TheZyklopp/Tretboot/README.md

# 🚤 Tretboot – Konstruktionsprojekt

## 📌 Projektbeschreibung

Dieses Projekt entstand im Rahmen einer universitären Aufgabe im Modul **Konstruktion**. Ziel war die Entwicklung und Konstruktion eines funktionsfähigen **Tretboots** mithilfe moderner CAD-Software.

---

## 🎯 Zielsetzung

* Entwicklung eines vollständigen 3D-CAD-Modells eines Tretboots
* Konstruktion aller relevanten Baugruppen
* Berücksichtigung von:

  * Funktionalität
  * Stabilität
  * Fertigbarkeit
  * Montage

---

## 🛠️ Inhalte des Projekts

Das Repository enthält:

* 📐 **CAD-Modelle** (Einzelteile & Baugruppen)
* 🧩 **Zusammenbau (Assembly)** des Tretboots
* 📄 **Technische Zeichnungen**
* ⚙️ Konstruktive Lösungen für:

  * Antriebssystem (Pedale → Vortrieb)
  * Rumpf / Schwimmkörper
  * Lenkmechanismus

---

## ⚙️ Funktionsprinzip

Das Tretboot basiert auf einem klassischen mechanischen Antrieb:

1. Fahrer tritt Pedale
2. Kraftübertragung über Kurbel und Antriebssystem
3. Umsetzung der Energie in Vortrieb (z. B. Propeller oder Schaufelrad)
4. Steuerung über Rudermechanismus

👉 Die Antriebskraft wird direkt durch Muskelkraft erzeugt und mechanisch weitergeleitet ([Google Patente][2])

---

## 🧠 Konstruktive Schwerpunkte

* 💡 **Leichtbauweise** zur Effizienzsteigerung
* ⚖️ **Stabilität im Wasser** (z. B. Katamaran-Prinzip)
* 🔧 **Modularer Aufbau** für einfache Montage
* 🔄 **Kraftübertragung** mit möglichst geringem Verlust

---

## 🧪 Vorgehensweise

1. Konzeptentwicklung
2. Skizzierung und Ideengenerierung
3. 3D-Modellierung (CAD)
4. Baugruppenbildung
5. Optimierung der Konstruktion
6. Erstellung technischer Zeichnungen

---

## 👨‍🎓 Kontext

* Studiengang: **Ingenieursinformatik**
* Modul: **Konstruktion
* Projektart: **Gruppenprojekt**

---

## 📦 Nutzung

Dieses Repository dient:

* zur Dokumentation des Projekts
* zur Präsentation der Konstruktion
* als Referenz für ähnliche CAD-Projekte

---

## ⚠️ Hinweise

* Das Projekt ist ein **Studienprojekt** und nicht für die Serienproduktion ausgelegt
* CAD-Dateien können je nach Softwareversion variieren

---

## 👥 Autoren

* Gruppe 7 – Konstruktion
* Philip
* Julian
* Yazan
* Ahmed

---

## 📄 Lizenz

Dieses Projekt dient ausschließlich zu Lehr- und Demonstrationszwecken.
