TheZyklopp/Tretboot/Konzept/Teil2/Zulässiges_Gesamtgewicht_Gruppe7.pdf

## 1 Geometrie des Schwimmkörpers

Der Schwimmkörper besteht aus zwei identischen Schwimmwülsten. Jeder Wulst setzt sich aus einem zylindrischen Teil und einer kugelförmigen Endform zusammen.

### 1.1 Gegebene Größen

- Außendurchmesser: Daußen = 0,20 m
- Wanddicke: t = 0,002 m
- Zylinderlänge (innen): LZyl = 2,8 m
- Anzahl der Schwimmwülste: n = 2

### 1.2 Innenabmessungen

Der Innendurchmesser ergibt sich zu:

Dinnen = Daußen − 2t = 0,20 − 2 · 0,002 = 0,196 m

Der Innenradius beträgt somit:

r =

Dinnen
2

= 0,098 m

## 2 Berechnung des Innenvolumens

### 2.1 Volumen des Zylinders

VZyl = πr²LZyl

VZyl = π · (0,098)²
- 2,8 ≈ 0,0846 m

3

### 2.2 Volumen der Kugel

VKugel =

4
3

πr³

VKugel =

4
3

π · (0,098)³ ≈ 0,00394 m

3

### 2.3 Gesamtvolumen eines Schwimmwulstes

V1 = VZyl + VKugel

V1 ≈ 0,0885 m

3

### 2.4 Gesamtvolumen beider Schwimmwülste

Vgesamt = 2 · V1 = 2 · 0,0885 = 0,177 m

3

## 3 Auftriebskraft

Die Auftriebskraft wird nach dem archimedischen Prinzip berechnet:

FA = ρ · g · V

mit:

- Wasserdichte: ρ = 1000 kg/m³
- Erdbeschleunigung: g = 9,81 m/s²

FA = 1000 · 9,81 · 0,177 ≈ 1736 N

## 4 Gewichtskraft des Boots

Die Masse des Boots beträgt:
mBoot = 46 kg

Die Gewichtskraft ergibt sich zu:

FG = mBoot · g = 46 · 9,81 ≈ 451 N

## 5 Nutzlast

Die maximal tragbare Masse ergibt sich aus:

mmax =

FA
g

=

1736
9,81

≈ 177 kg

Abzüglich der Bootsmasse ergibt sich die theoretische Nutzlast:

mNutz = 177 − 46 ≈ 131 kg

## 6 Ergebnis

Die beiden Schwimmwülste erzeugen eine maximale Auftriebskraft von ca. 1,74 kN. Nach Abzug des Eigengewichts des Boots verbleibt eine theoretische Nutzlast von etwa 131 kg. In der Praxis ist aufgrund von Sicherheitsfaktoren eine geringere Nutzlast anzusetzen.

## 7 Sicherheitsfaktor

Der Sicherheitsfaktor gegen Sinken wird als Verhältnis der maximalen Auftriebskraft zur Gewichtskraft des Boots definiert:

S =

FA
FG

Mit:
FA = 1736 N und FG = 451 N

ergibt sich:

S =

1736
451

≈ 3,85

Der Sicherheitsfaktor beträgt somit:

S ≈ 3,9

Dies bedeutet, dass der Schwimmkörper das rund 3,9-fache seines Eigengewichts tragen kann, bevor ein vollständiges Eintauchen erfolgt.
