TheZyklopp/Tretboot/Konzept/Teil2/Preisliste_Gruppe7.pdf

## Preisliste

Bauteilnummer Bezeichnung | Anzahl | Einzelpreis in € | Gesamtpreis in €
1 | Anschlag | 4
2 | Sitzlehne (Rohteil) | 1 | 28,47 | 28,47
3 | Sitzplatte (Rohteil) 1 | 28,47 | 28,47
4 | Stopper | 4
5 | Tritt OT | 2
6 | Tritt UT | 2
7 | Trittstange | 1
8 | Stopper klein | 4
9 | Verbinder | 2
10 | Distanz | 1
11 | Schaufelplatten | 4
12 | Seitenscheibe | 2
13 | Schwimmkörper | 2
14 | Ringschrauben-
| mutter | 4 | 4,9 | 19,6
15 | Lager Schaufelrad 2 | 11,18 | 22,36
16 | Quertraverse vorne
| (Rohteil) | 2 | 13,45 | 26,9
17 | Traversen Deckel 10
18 | Quertraverse Sitz
| (Rohteil) | 2 | 13,45 | 26,9
19 | Längs Traverse
| vorne (Rohteil) | 2 | 13,45 | 26,9
20 | Längs Traverse
| hinten (Rohteil) | 2 | 13,45 | 26,9
21 | Stange Schaufelrad 2
22 | Scharnier 1488A1 | 2 | 30,03 | 60,06
23 | Steuerteil | 1
24 | Lager Schaufelrad | 6 | 11,18 | 67,08
25 | Verbinder 3 | 1
26 | Quertraverse Sitz
| (Rohteil) | 1 | 13,45 | 13,45
27 | Ruder | 1
28 | Ruderstange | 1
29 | Verbinder 2 | 1
30 | U Stück | 4
31 | Verbindung | 1
32 | Steuerhebel | 1
33 | Kettenrad V
| 6799K144 | 1 | 114,91 | 144,91
34 | Kettenrad H
| 6799K141 | 1 | 95,88 | 95,88
35 | Rollkette 7210K2
| 15ft. | 1 | 120,47 | 120,47
36 | 18-8 Clevis Pin
| 90378A705 | 4 | 7,4 | 29,6

37 | Schrader- Ventil | 2
38 | Cotter Pin
| 98350A111 | 4 | 1,54 | 6,16
39 | Sechskantmutter
| M10 | 16 | 0,35 | 5,6
40 | Innensechskant-
| schraube M5x8 | 2 | 0,1 | 0,2
41 | Innensechskant-
| schraube M5x25 | 1 | 0,06 | 0,06
42 | Innensechskant-
| schraube M8x25 | 2 | 0,11 | 0,22
43 | Innensechskant-
| schraube M8x16 | 2 | 0,1 | 0,2
44 | Innensechskant-
| Schraube M5x16 | 2 | 0,33 | 0,66
45 | Innensechskant-
| schraube M10x60 | 14 | 0,59 | 8,24
46 | Innensechskant-
| schraubeM5x20 | 16 | 0,33 | 5,28
47 | Unterlegscheibe | 2 | 0,1 | 0,2
48 | Innensechskant-
| schraube mit
| Senkkopf M10x70 | 4 | 1,33 | 5,32
49 | Innensechskant-
| schraube mit
| Senkkopf M6x60 | 4 | 0,74 | 2,96
50 | Innensechskant-
| schraube mit
| Senkkopf M8x40 | 8 | 0,41 | 3,28
51 | Innensechskant-
| schraube mit
| Senkkopf M5x50 | 8 | 0,51 | 4,08
52 | Rod Nut 8404N13 | 3 | 20,06 | 60,18
| | | | 840,61

### Die Preise der restlichen Teile werden ggf. nachgereicht nach anfrage der

Fertigungskosten bei einer Firma.
