TheZyklopp/Tretboot/Konzept/Teil1/Papierkorb/Funktionsstruktur  (1).pdf

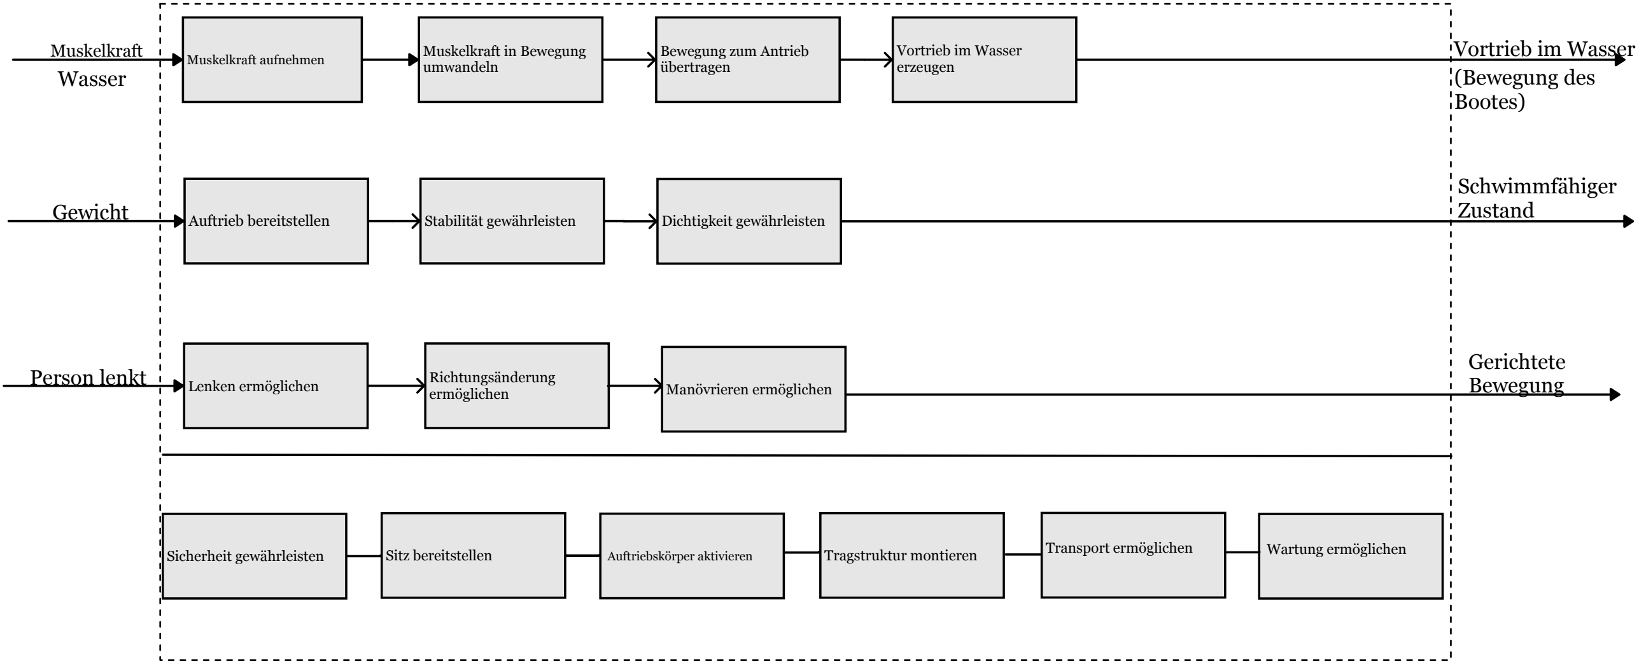
[picture p1: figure]
Muskelkraft aufnehmen; Muskelkraft in Bewegung; umwandeln; Bewegung zum Antrieb übertragen; Vortrieb im Wasser erzeugen; Auftrieb bereitstellen; Stabilität gewährleisten; Dichtigkeit gewährleisten; Lenken ermöglichen; (Bewegung des Bootes); Schwimmfähiger Zustand; Gerichtete Bewegung; Muskelkraft; Vortrieb im Wasser; Wasser; Gewicht; Person lenkt; Sicherheit gewährleisten; Sitz bereitstellen; Auftriebskörper aktivieren; Richtungsänderung; ermöglichen; Manövrieren ermöglichen; Tragstruktur montieren; Transport ermöglichen; Wartung ermöglichen
