TheZyklopp/Tretboot/Konzept/Teil2/Stückliste_Gruppe7.pdf

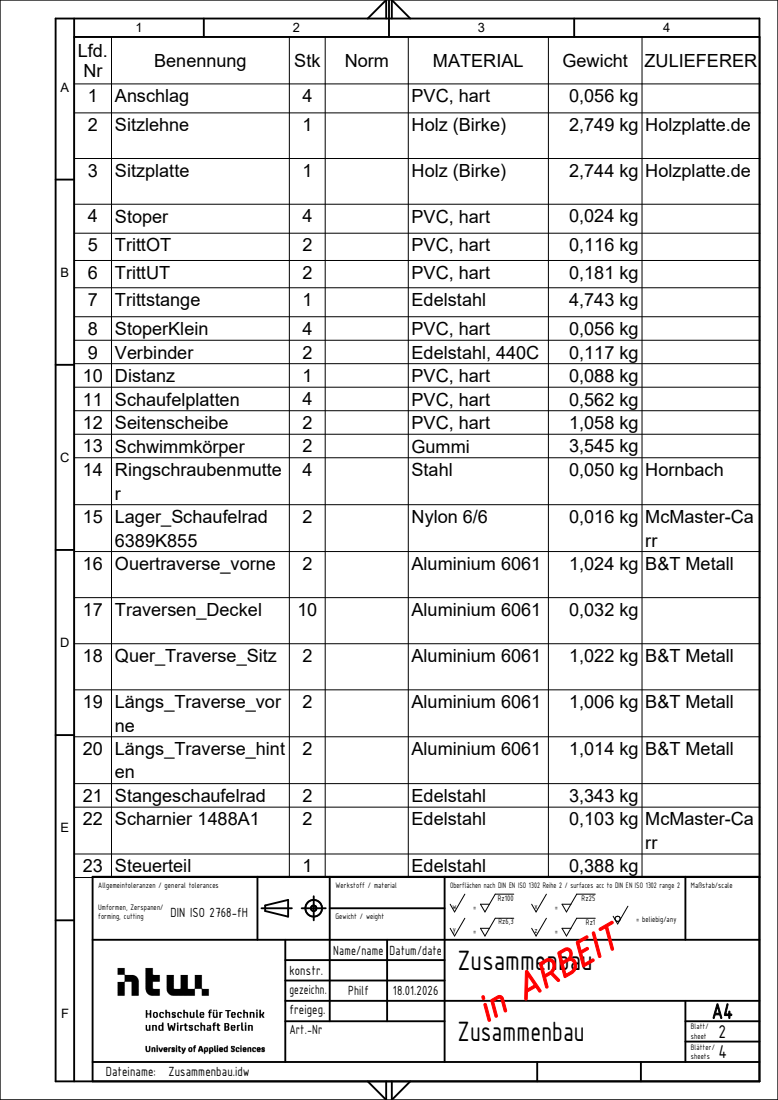
[picture p4: page 1]
sheets; in ARBEIT

Nr | Benennung | Stk | Norm | MATERIAL | Gewicht | ZULIEFERER Lfd.

1 | Anschlag | 4 | | PVC, hart | 0,056 kg
2 | Sitzlehne | 1 | | Holz (Birke) | 2,749 kg | Holzplatte.de

3 | Sitzplatte | 1 | | Holz (Birke) | 2,744 kg | Holzplatte.de

4 | Stoper | 4 | | PVC, hart | 0,024 kg
5 | TrittOT | 2 | | PVC, hart | 0,116 kg
6 | TrittUT | 2 | | PVC, hart | 0,181 kg
7 | Trittstange | 1 | | Edelstahl | 4,743 kg
8 | StoperKlein | 4 | | PVC, hart | 0,056 kg
9 | Verbinder | 2 | | Edelstahl, 440C | 0,117 kg
C | 10 | Distanz | 1 | | PVC, hart | 0,088 kg
11 | Schaufelplatten | 4 | | PVC, hart | 0,562 kg
12 | Seitenscheibe | 2 | | PVC, hart | 1,058 kg
13 | Schwimmkörper | 2 | | Gummi | 3,545 kg
14 | Ringschraubenmutte r | 4 | | Stahl | 0,050 kg | Hornbach

15 | Lager_Schaufelrad 6389K855 | 2 | | Nylon 6/6 | 0,016 kg | McMaster-Ca rr

D | 16 | Ouertraverse_vorne | 2 | | Aluminium 6061 | 1,024 kg | B&T Metall

17 | Traversen_Deckel | 10 | | Aluminium 6061 | 0,032 kg

18 | Quer_Traverse_Sitz | 2 | | Aluminium 6061 | 1,022 kg | B&T Metall

19 | Längs_Traverse_vor ne | 2 | | Aluminium 6061 | 1,006 kg | B&T Metall

E | 20 | Längs_Traverse_hint en | 2 | | Aluminium 6061 | 1,014 kg | B&T Metall

21 | Stangeschaufelrad | 2 | | Edelstahl | 3,343 kg
22 | Scharnier 1488A1 | 2 | | Edelstahl | 0,103 kg | McMaster-Ca rr

23 | Steuerteil | 1 | | Edelstahl | 0,388 kg

Allgemeintoleranzen / general tolerances forming, cutting DIN ISO 2768-fH | | | | | | Oberflächen nach DIN EN ISO 1302 Reihe 2 / surfaces acc to DIN EN ISO 1302 range 2 y = = Rz1 z = Rz100 x = Rz25 Rz6,3 = beliebig/any w | Maßstab/scale Umformen, Zerspanen/

Zusammenbau Werkstoff / material Gewicht / weight

Name/name | Datum/date
konstr.
gezeichn. | Philf | 18.01.2026
freigeg. | | | Zusammenbau | A4
Art.-Nr | | | | 2 Blatt/ sheet Blätter/

Dateiname: Zusammenbau.idw

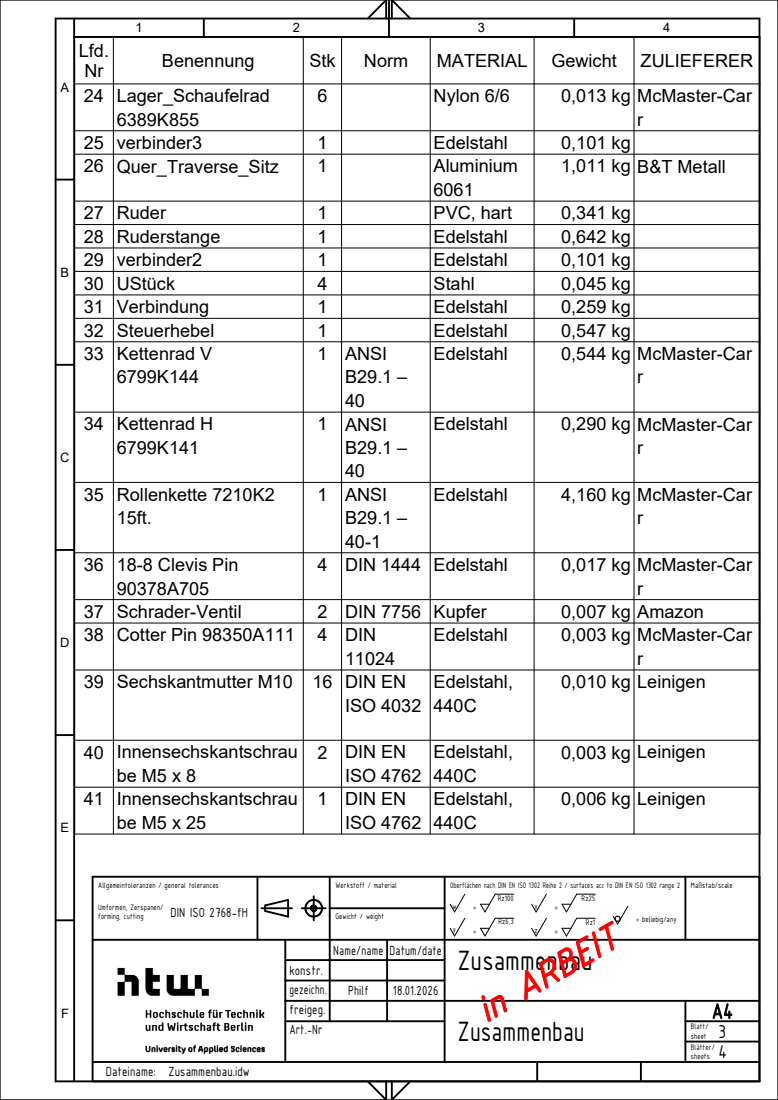
[picture p5: page 2]
3 Blatt/; in ARBEIT

24 | Lager_Schaufelrad 6389K855 | 6 | | Nylon 6/6 | 0,013 kg | McMaster-Car r

25 | verbinder3 | 1 | | Edelstahl | 0,101 kg
26 | Quer_Traverse_Sitz | 1 | | Aluminium 6061 | 1,011 kg | B&T Metall

27 | Ruder | 1 | | PVC, hart | 0,341 kg
28 | Ruderstange | 1 | | Edelstahl | 0,642 kg
29 | verbinder2 | 1 | | Edelstahl | 0,101 kg
30 | UStück | 4 | | Stahl | 0,045 kg
31 | Verbindung | 1 | | Edelstahl | 0,259 kg
32 | Steuerhebel | 1 | | Edelstahl | 0,547 kg
33 | Kettenrad V 6799K144 | 1 | ANSI B29.1 – 40 | Edelstahl | 0,544 kg | McMaster-Car r

34 | Kettenrad H 6799K141 | 1 | ANSI B29.1 – 40 | Edelstahl | 0,290 kg | McMaster-Car r

35 | Rollenkette 7210K2 15ft. | 1 | ANSI B29.1 – 40-1 | Edelstahl | 4,160 kg | McMaster-Car r

D | 36 | 18-8 Clevis Pin 90378A705 | 4 | DIN 1444 | Edelstahl | 0,017 kg | McMaster-Car r

37 | Schrader-Ventil | 2 | DIN 7756 | Kupfer | 0,007 kg | Amazon
38 | Cotter Pin 98350A111 | 4 | DIN 11024 | Edelstahl | 0,003 kg | McMaster-Car r

39 | Sechskantmutter M10 | 16 | DIN EN ISO 4032 | Edelstahl, 440C | 0,010 kg | Leinigen

40 | Innensechskantschrau be M5 x 8 | 2 | DIN EN ISO 4762 | Edelstahl, 440C | 0,003 kg | Leinigen

41 | Innensechskantschrau be M5 x 25 | 1 | DIN EN ISO 4762 | Edelstahl, 440C | 0,006 kg | Leinigen

Allgemeintoleranzen / general tolerances forming, cutting DIN ISO 2768-fH | | | | | Oberflächen nach DIN EN ISO 1302 Reihe 2 / surfaces acc to DIN EN ISO 1302 range 2 y = = Rz1 z = Rz100 x = Rz25 Rz6,3 = beliebig/any w | Maßstab/scale Umformen, Zerspanen/

Zusammenbau Werkstoff / material Gewicht / weight

Name/name | Datum/date
konstr.
gezeichn. | Philf | 18.01.2026
freigeg. | | | | A4

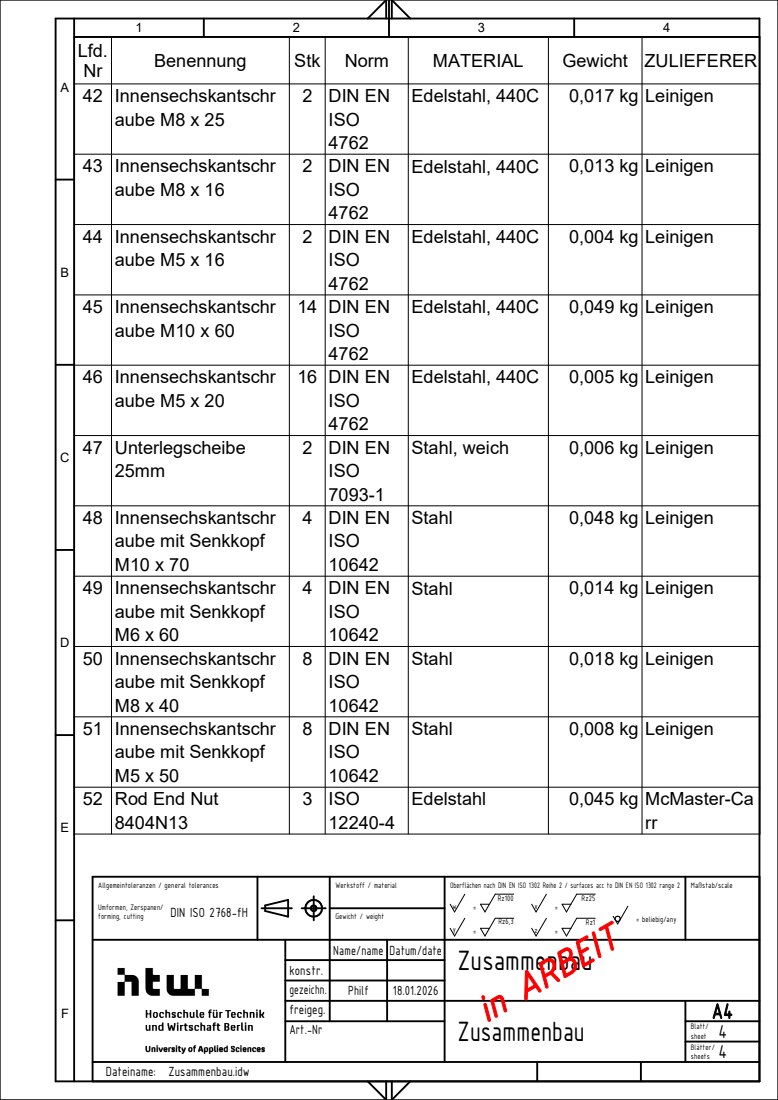
[picture p6: page 3]
4 Blatt/; in ARBEIT

42 | Innensechskantschr aube M8 x 25 | 2 | DIN EN ISO 4762 | Edelstahl, 440C | 0,017 kg | Leinigen

43 | Innensechskantschr aube M8 x 16 | 2 | DIN EN ISO 4762 | Edelstahl, 440C | 0,013 kg | Leinigen

44 | Innensechskantschr aube M5 x 16 | 2 | DIN EN ISO 4762 | Edelstahl, 440C | 0,004 kg | Leinigen

45 | Innensechskantschr aube M10 x 60 | 14 | DIN EN ISO 4762 | Edelstahl, 440C | 0,049 kg | Leinigen

C | 46 | Innensechskantschr aube M5 x 20 | 16 | DIN EN ISO 4762 | Edelstahl, 440C | 0,005 kg | Leinigen

47 | Unterlegscheibe 25mm | 2 | DIN EN ISO 7093-1 | Stahl, weich | 0,006 kg | Leinigen

48 | Innensechskantschr aube mit Senkkopf M10 x 70 | 4 | DIN EN ISO 10642 | Stahl | 0,048 kg | Leinigen

49 | Innensechskantschr aube mit Senkkopf M6 x 60 | 4 | DIN EN ISO 10642 | Stahl | 0,014 kg | Leinigen

50 | Innensechskantschr aube mit Senkkopf M8 x 40 | 8 | DIN EN ISO 10642 | Stahl | 0,018 kg | Leinigen

51 | Innensechskantschr aube mit Senkkopf M5 x 50 | 8 | DIN EN ISO 10642 | Stahl | 0,008 kg | Leinigen

52 | Rod End Nut 8404N13 | 3 | ISO 12240-4 | Edelstahl | 0,045 kg | McMaster-Ca rr

Allgemeintoleranzen / general tolerances forming, cutting DIN ISO 2768-fH | | | | | Oberflächen nach DIN EN ISO 1302 Reihe 2 / surfaces acc to DIN EN ISO 1302 range 2 y = = Rz1 z = Rz100 x = Rz25 Rz6,3 = beliebig/any w | Maßstab/scale Umformen, Zerspanen/

Zusammenbau Werkstoff / material Gewicht / weight

Name/name | Datum/date
konstr.
gezeichn. | Philf | 18.01.2026
freigeg. | | | | A4
