TheZyklopp/Tretboot/(list of files, cad)

Other CAD files:
2D Zeichnungen/Ahmed alamwi/6905N38_Machinable-Bore Corrosion-Resistant Sprocket-2Z.idw
2D Zeichnungen/Ahmed alamwi/Rod End Nuts - KopieZ.idw
2D Zeichnungen/Ahmed alamwi/Valve_end-00Z.idw
2D Zeichnungen/Ahmed alamwi/Valve_seat-Z.idw
2D Zeichnungen/Julian Faber/Längs_Traverse_vorne.idw
2D Zeichnungen/Julian Faber/Quer_Traverse_Sitz.idw
2D Zeichnungen/Julian Faber/Sitzplatte.idw
2D Zeichnungen/Julian Faber/Traversen_Deckel.idw
2D Zeichnungen/Philip Faber/Verbindung.idw
2D Zeichnungen/Philip Faber/ustück.idw
2D Zeichnungen/Yazan Al Hefawi/GestellVerbinder 2D von Yazan Al Hefawi 01.idw
2D Zeichnungen/Yazan Al Hefawi/Schrader_tube_18,5x7.7-1 2D von Alhefawi01.idw
2D Zeichnungen/Yazan Al Hefawi/Verbindung-1 2D Al Hefawi 01.idw
Ahmed/HTW-000166.ipt
Gestell/3112T51_Zinc-Plated Steel Round Eye Nut - for Lifting.ipt
Gestell/Gestell_zsm.iam
Gestell/LagerBund.ipt
Gestell/Lager_Schaufelrad.ipt
Gestell/Längs_Traverse_hinten.ipt
Gestell/Längs_Traverse_vorne.ipt
Gestell/Ouertraverse_vorne.ipt
Gestell/Quer_Traverse_Sitz.ipt
Gestell/Traversen_Deckel.ipt
Gestell/Verbinder.ipt
Gestell/richtungstange.ipt
Konzept/Teil2/Zusammenbau_Gruppe7.iam
Konzept/Teil2/Zusammenbau_Gruppe7.idw
Schwimmkoerper/InnenvolumenLuft.ipt
Schwimmkoerper/Schwimmkoerper.iam
Schwimmkoerper/Ventil_Schrader/Poppet_seal-00.ipt
Schwimmkoerper/Ventil_Schrader/Schrader_bicycle_valve-00.iam
Schwimmkoerper/Ventil_Schrader/Schrader_plug_valve.iam
Schwimmkoerper/Ventil_Schrader/Schrader_tube_18,5x7.7.ipt
Schwimmkoerper/Ventil_Schrader/Vale_outer_seal-00.ipt
Schwimmkoerper/Ventil_Schrader/Valve_cap_seal-00.ipt
Schwimmkoerper/Ventil_Schrader/Valve_end-00.ipt
Schwimmkoerper/Ventil_Schrader/Valve_pin.ipt
Schwimmkoerper/Ventil_Schrader/Valve_seat-.idw
Schwimmkoerper/Ventil_Schrader/Valve_seat-00.ipt
Schwimmkoerper/Ventil_Schrader/Valve_spring-00.ipt
Schwimmkoerper/Ventil_Schrader/Valve_threads-00.ipt
Schwimmkoerper/Wulst.ipt
Sitz/1598A18_Mortise-Mount Hinge with Holes.ipt
Sitz/Gelenk.iam
Sitz/GelenkOT.ipt
Sitz/GelenkStift.ipt
Sitz/GelenkUT.ipt
Sitz/Sitzlehne.ipt
Sitz/Sitzplatte.ipt
Sitz/Stoper.ipt
Sitz/scharnier.iam
Sitz/sitz_zusammenbau.iam
Steuern/6905N38_Machinable-Bore Corrosion-Resistant Sprocket-2.idw
Steuern/ClevisPin.ipt
Steuern/GestellVerbinder 2D von Yazan Al Hefawi.idw
Steuern/HTW-000654.ipt
Steuern/HTW-000679.ipt
Steuern/HTW-000681.ipt
Steuern/HTW-000692.ipt
Steuern/HTW-000702.ipt
Steuern/Rod End Nuts.idw
Steuern/Rod End Nuts.ipt
Steuern/Schrader_tube_18,5x7.7-1 2D von Alhefawi.idw
Steuern/Valve_end-00.idw
Steuern/Verbindung-1 2D Al Hefawi.idw
Steuern/Verbindung.ipt
Steuern/clevisPin30.ipt
Steuern/cotterpin.ipt
Steuern/steuerstange.ipt
Steuern/ustück.ipt
Tritt/6799K141_Machinable-Bore Corrosion-Resistant Sprocket.ipt
Tritt/6799K144_Machinable-Bore Corrosion-Resistant Sprocket/6799K144_Machinable-Bore Corrosion-Resistant Sprocket/6799K144_Machinable-Bore Corr.ipt
Tritt/6905N38_Machinable-Bore Corrosion-Resistant Sprocket.ipt
Tritt/Pedale.iam
Tritt/Stange.iam
Tritt/Stopper.ipt
Tritt/TrittOT.ipt
Tritt/TrittUT.ipt
Tritt/Trittstange.ipt
Tritt/stopper2.ipt
Zusammenbau/Konstruktions-Assistent/HTW-000365.iam
Zusammenbau/Konstruktions-Assistent/HTW-000366.ipt
Zusammenbau/Konstruktions-Assistent/HTW-000642.iam
Zusammenbau/Konstruktions-Assistent/HTW-000643.ipt
schaufelrad/Distanz.ipt
schaufelrad/Schaufelplatten.ipt
schaufelrad/Schaufelrad.iam
schaufelrad/Seitenscheibe.ipt
schaufelrad/Stangeschaufelrad.ipt
