TheZyklopp/Tretboot/Konzept/Teil1/Papierkorb/Skizze Boot.pdf

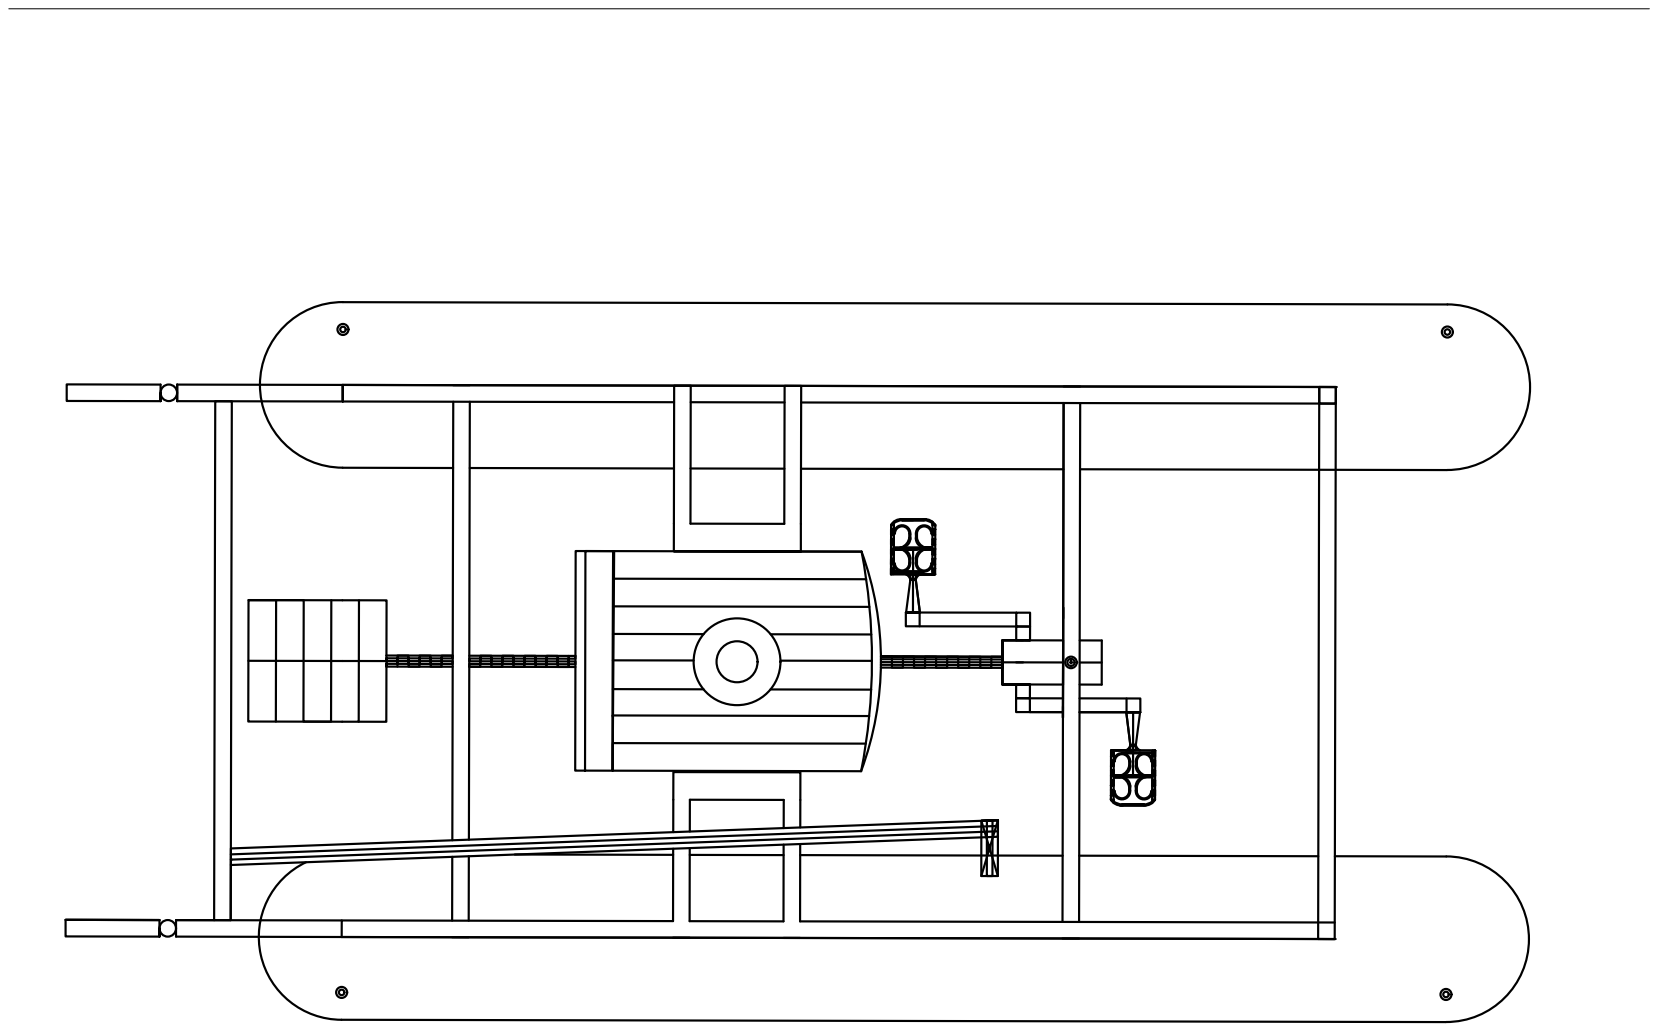
[picture p29: page 1]
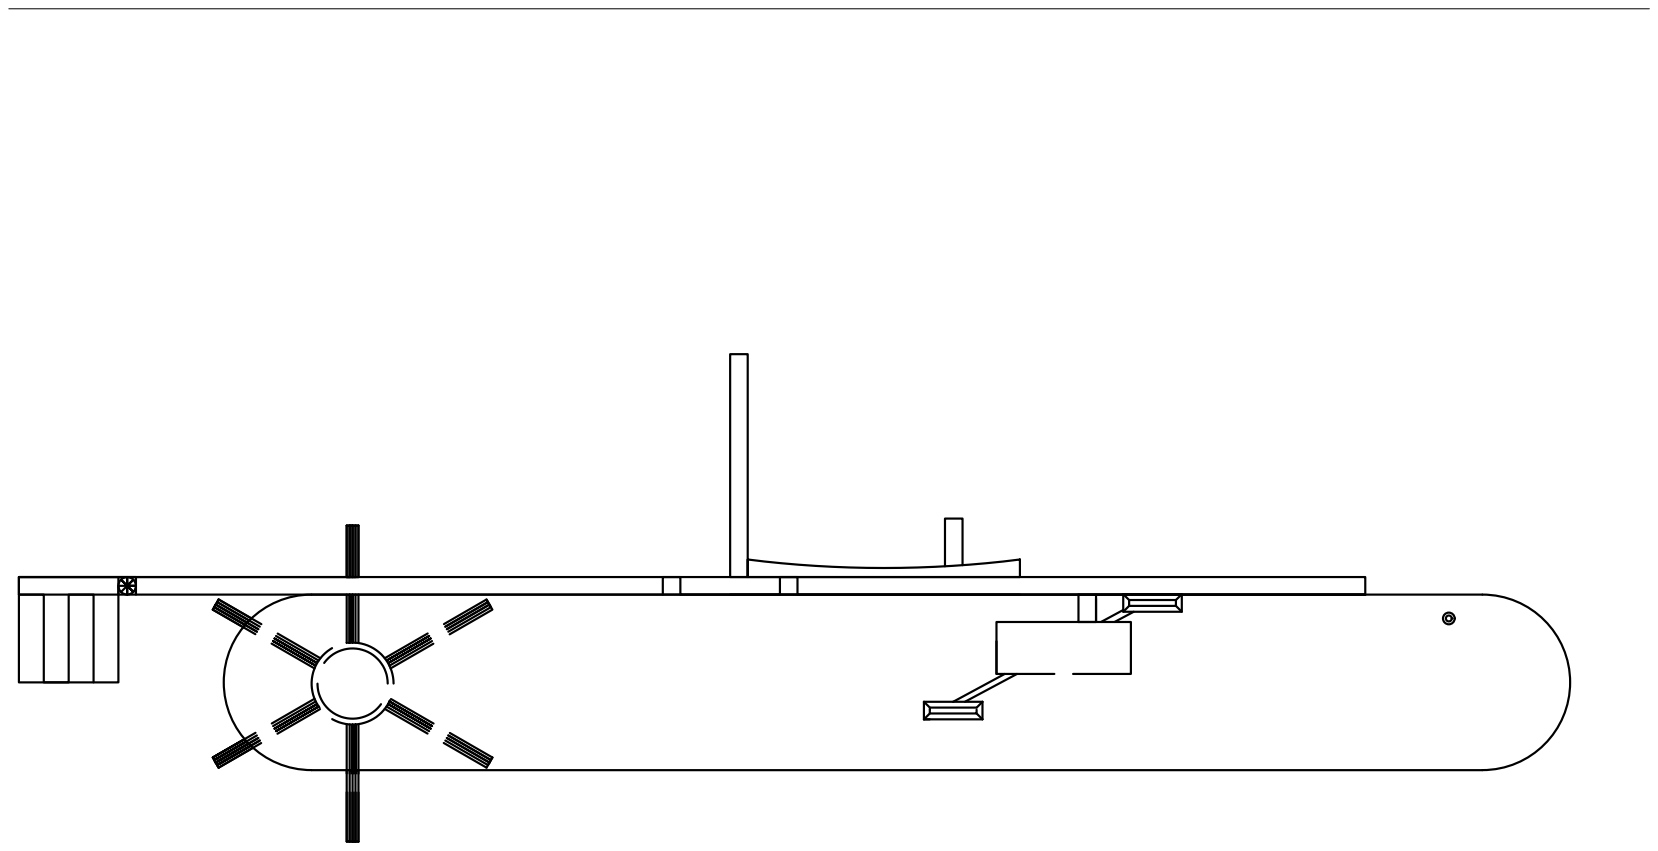
[picture p30: page 2]
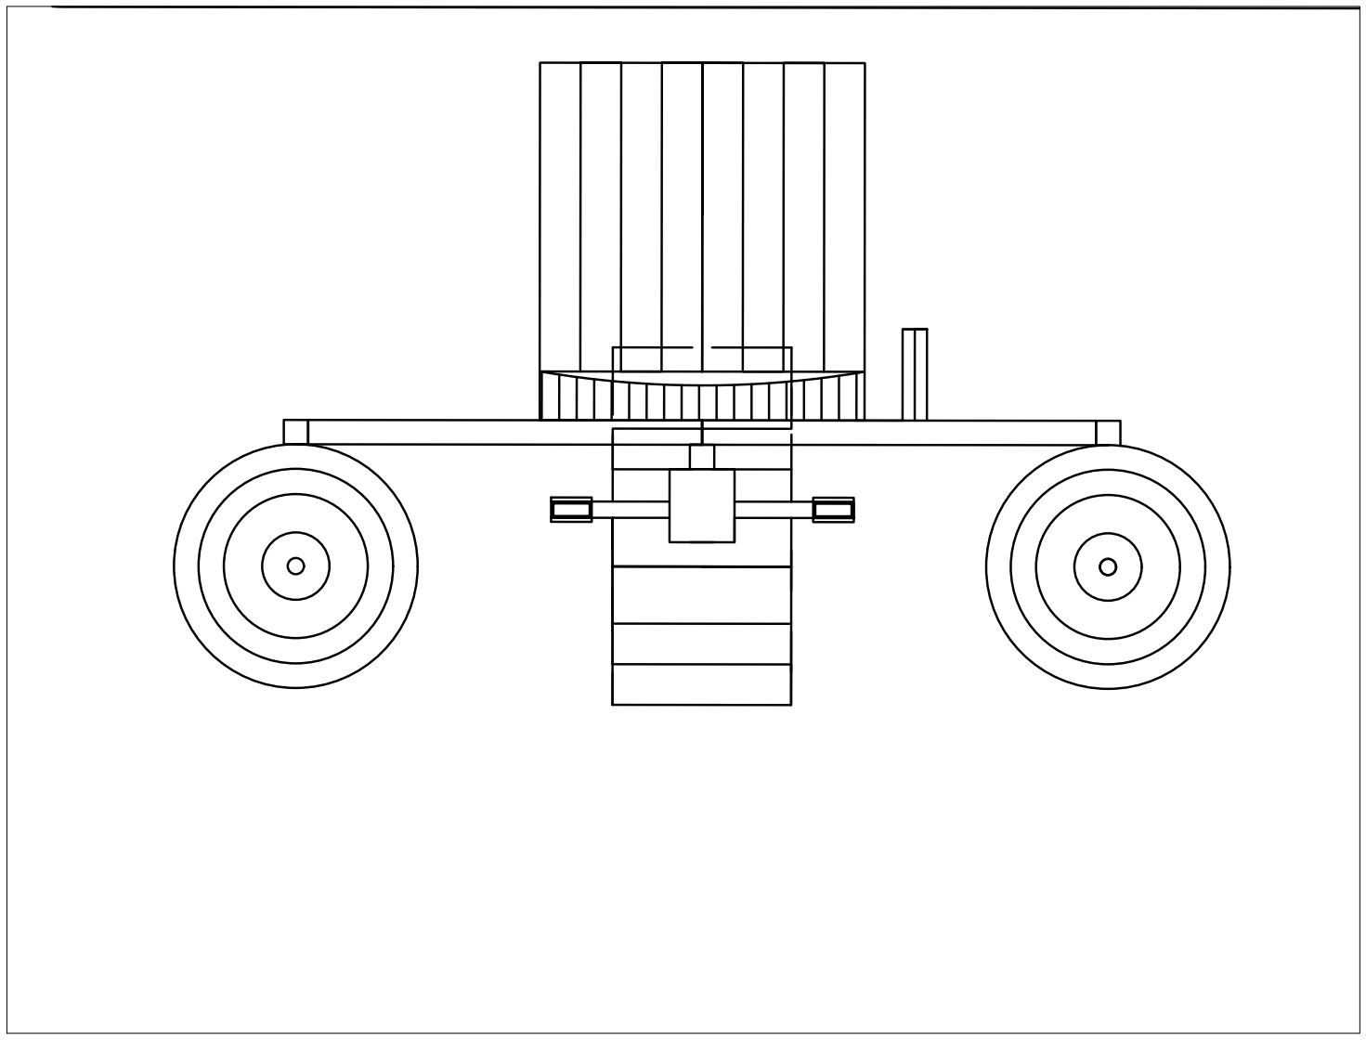
[picture p31: figure]
