TheZyklopp/Tretboot/2D Zeichnungen/Ahmed alamwi/6905N38_Machinable-Bore Corrosion-Resistant Sprocket-2Z1.pdf

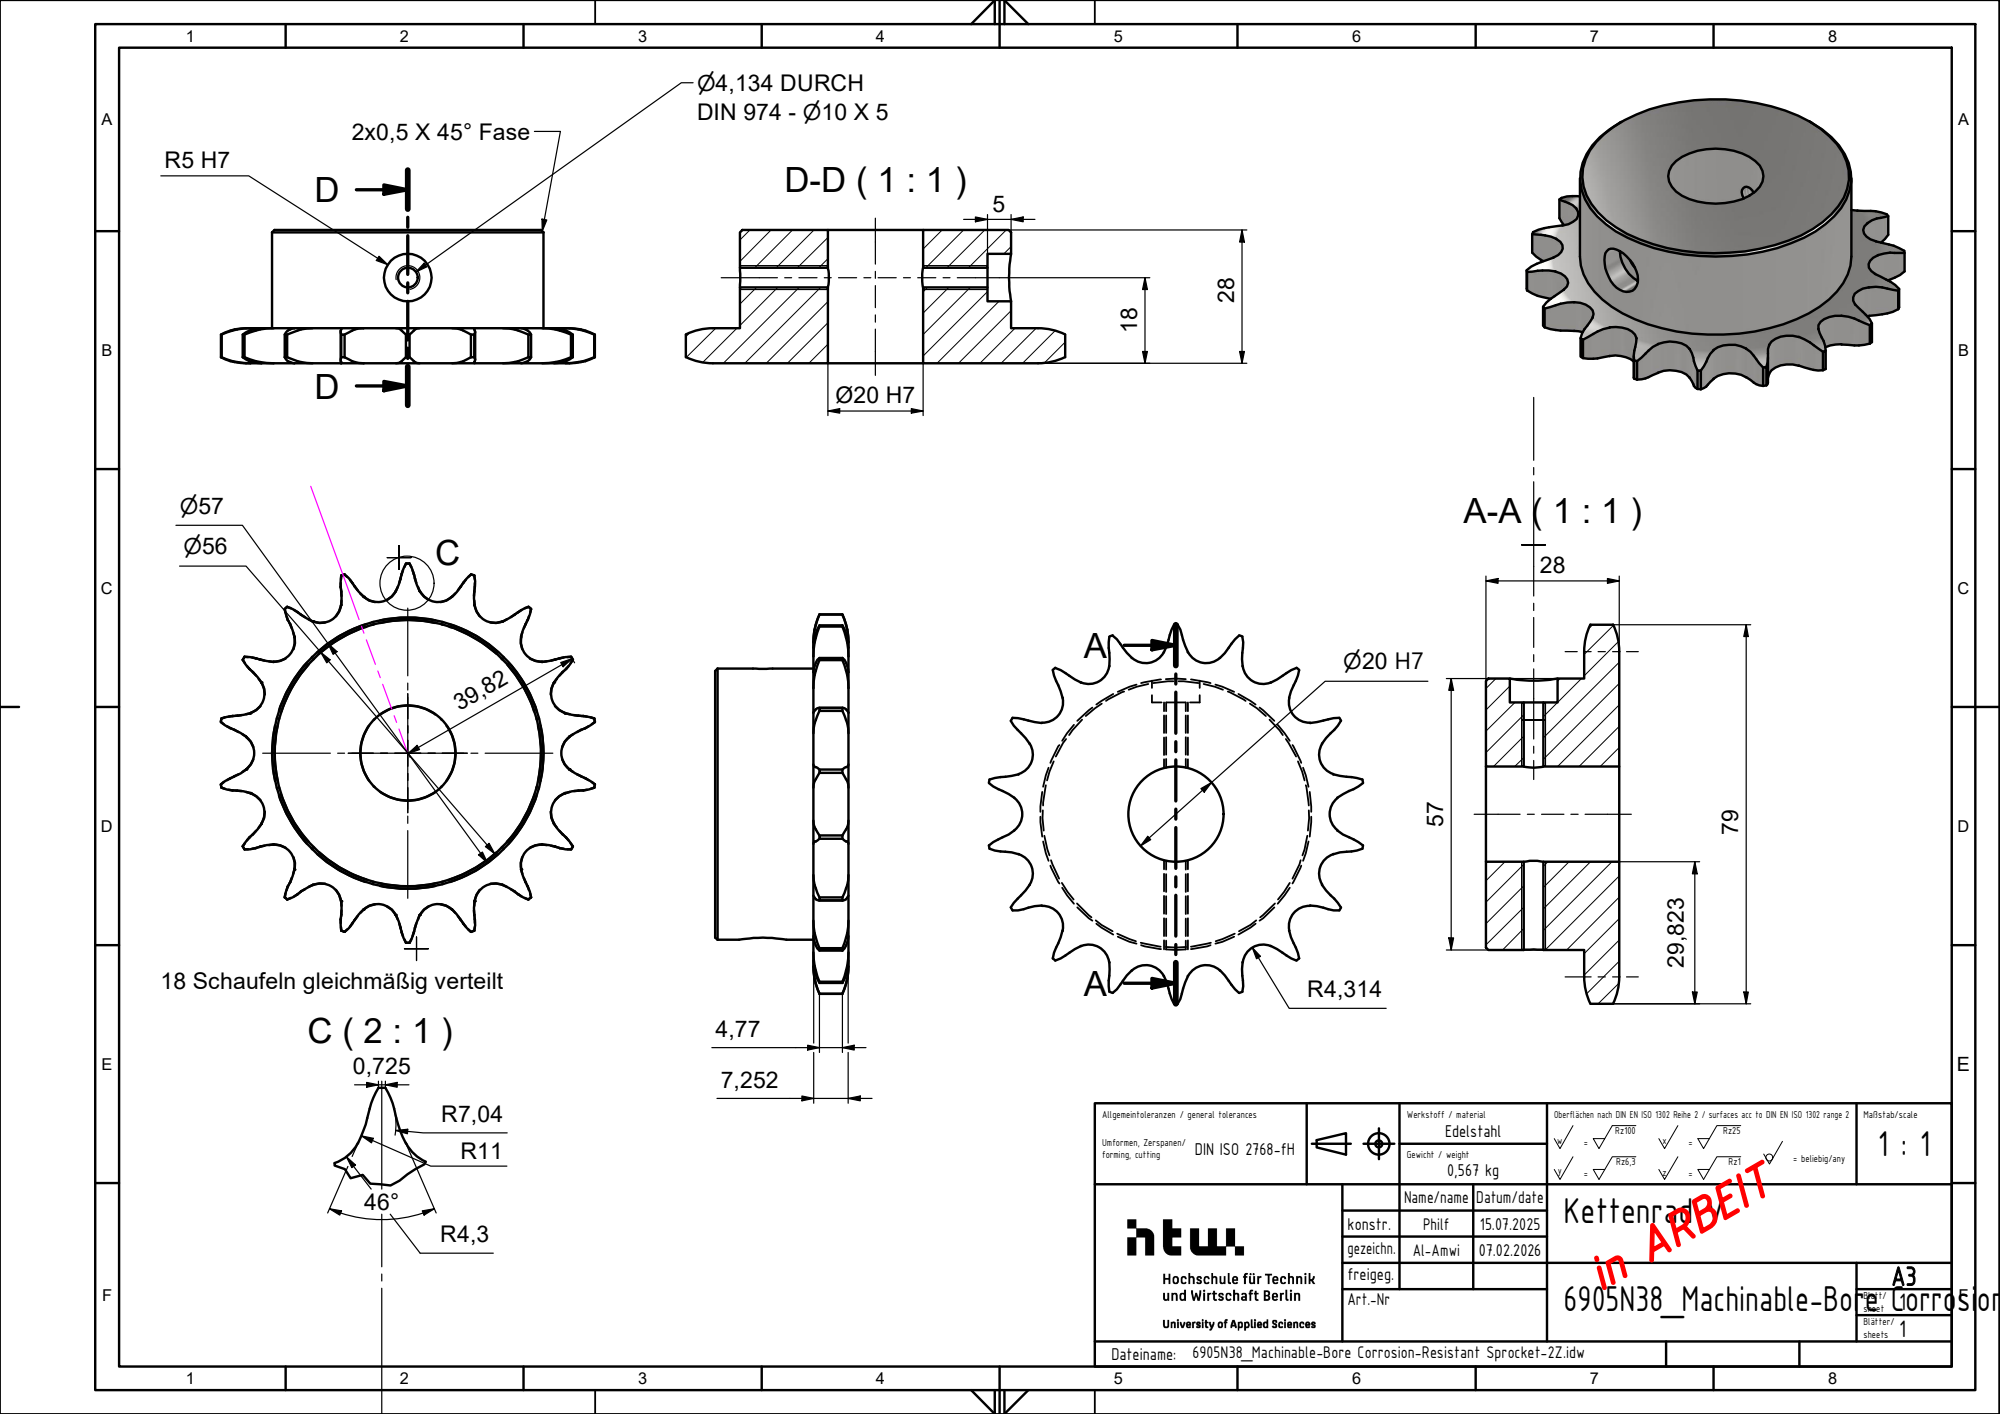
[picture p7: page 1]
6905N38_Machinable-Bore Corrosion; Werkstoff / material; Gewicht / weight 0,567 kg; = beliebig/any; Umformen, Zerspanen/; forming, cutting; DIN ISO 2768-fH; in ARBEIT; 2x0,5 X 45° Fase; ⌀4,134 DURCH DIN 974 - ⌀10 X 5

18 Schaufeln gleichmäßig verteilt

Allgemeintoleranzen / general tolerances

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

Name/name | Datum/date | Kettenrad V

konstr. | Philf | 15.07.2025
gezeichn. | Al-Amwi | 07.02.2026
freigeg. | | | | A3
Art.-Nr | | | | Blatt/ 1 sheet

Dateiname: 6905N38_Machinable-Bore Corrosion-Resistant Sprocket-2Z.idw
