TheZyklopp/Tretboot/2D Zeichnungen/Ahmed alamwi/Rod End Nuts - KopieZ22.pdf

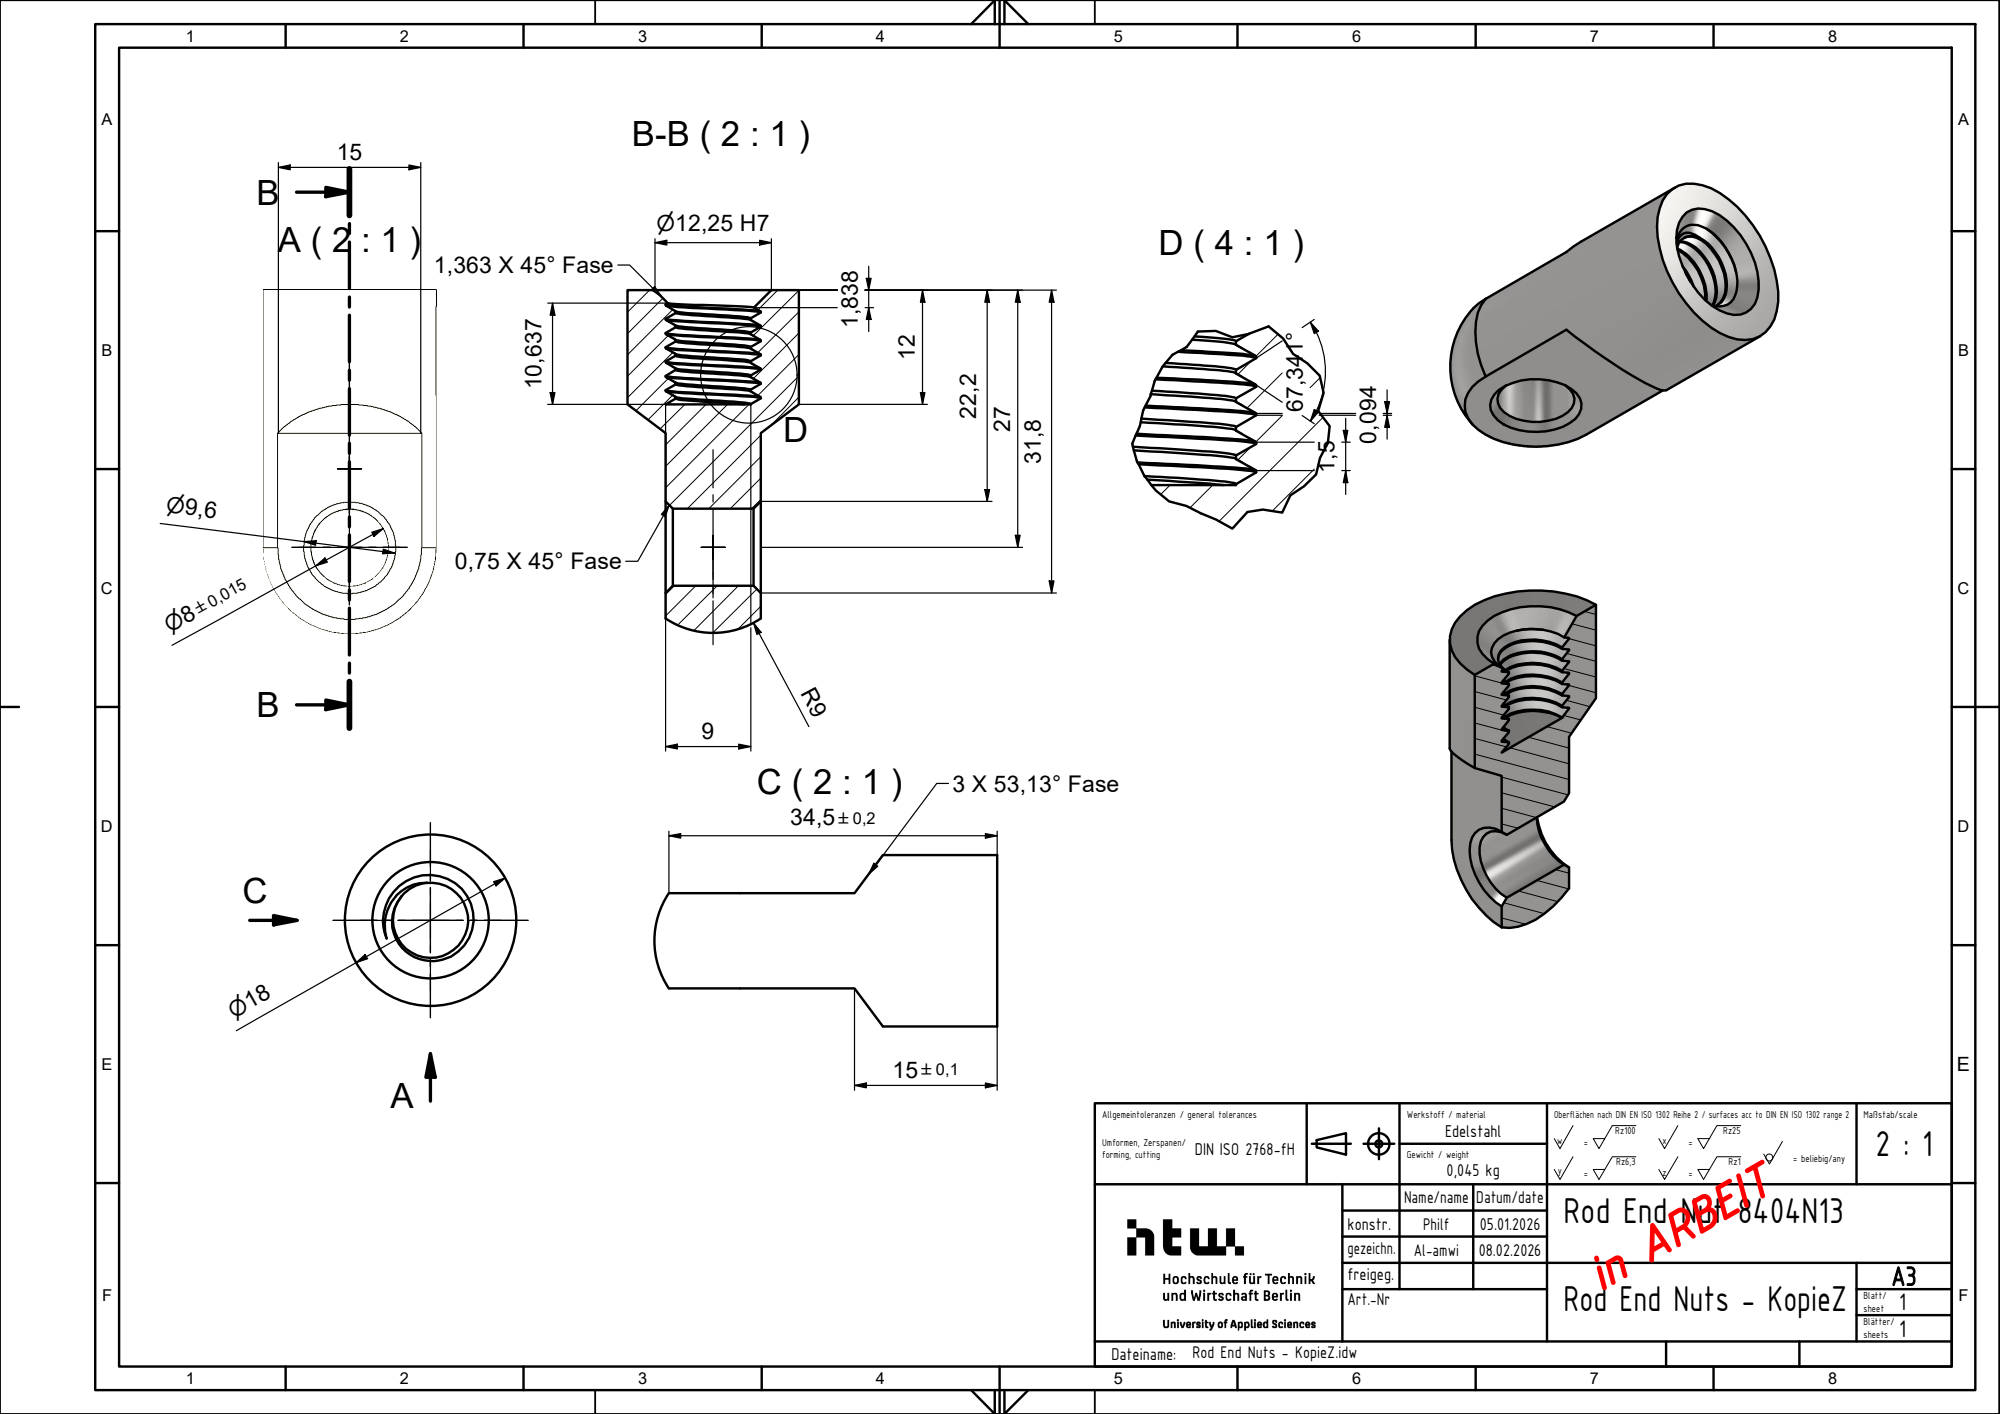
[picture p8: page 1]
Werkstoff / material; Gewicht / weight 0,045 kg; = beliebig/any; Umformen, Zerspanen/; forming, cutting; DIN ISO 2768-fH; in ARBEIT; 3 X 53,13° Fase; 1,363 X 45° Fase; 0,75 X 45° Fase

Allgemeintoleranzen / general tolerances

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

Name/name | Datum/date | Rod End Nut 8404N13

konstr. | Philf | 05.01.2026
gezeichn. | Al-amwi | 08.02.2026
freigeg. | | | Rod End Nuts - KopieZ | A3
Art.-Nr | | | | Blatt/ 1 sheet

Dateiname: Rod End Nuts - KopieZ.idw
