TheZyklopp/Tretboot/2D Zeichnungen/Ahmed alamwi/Valve_end-00Z1.pdf

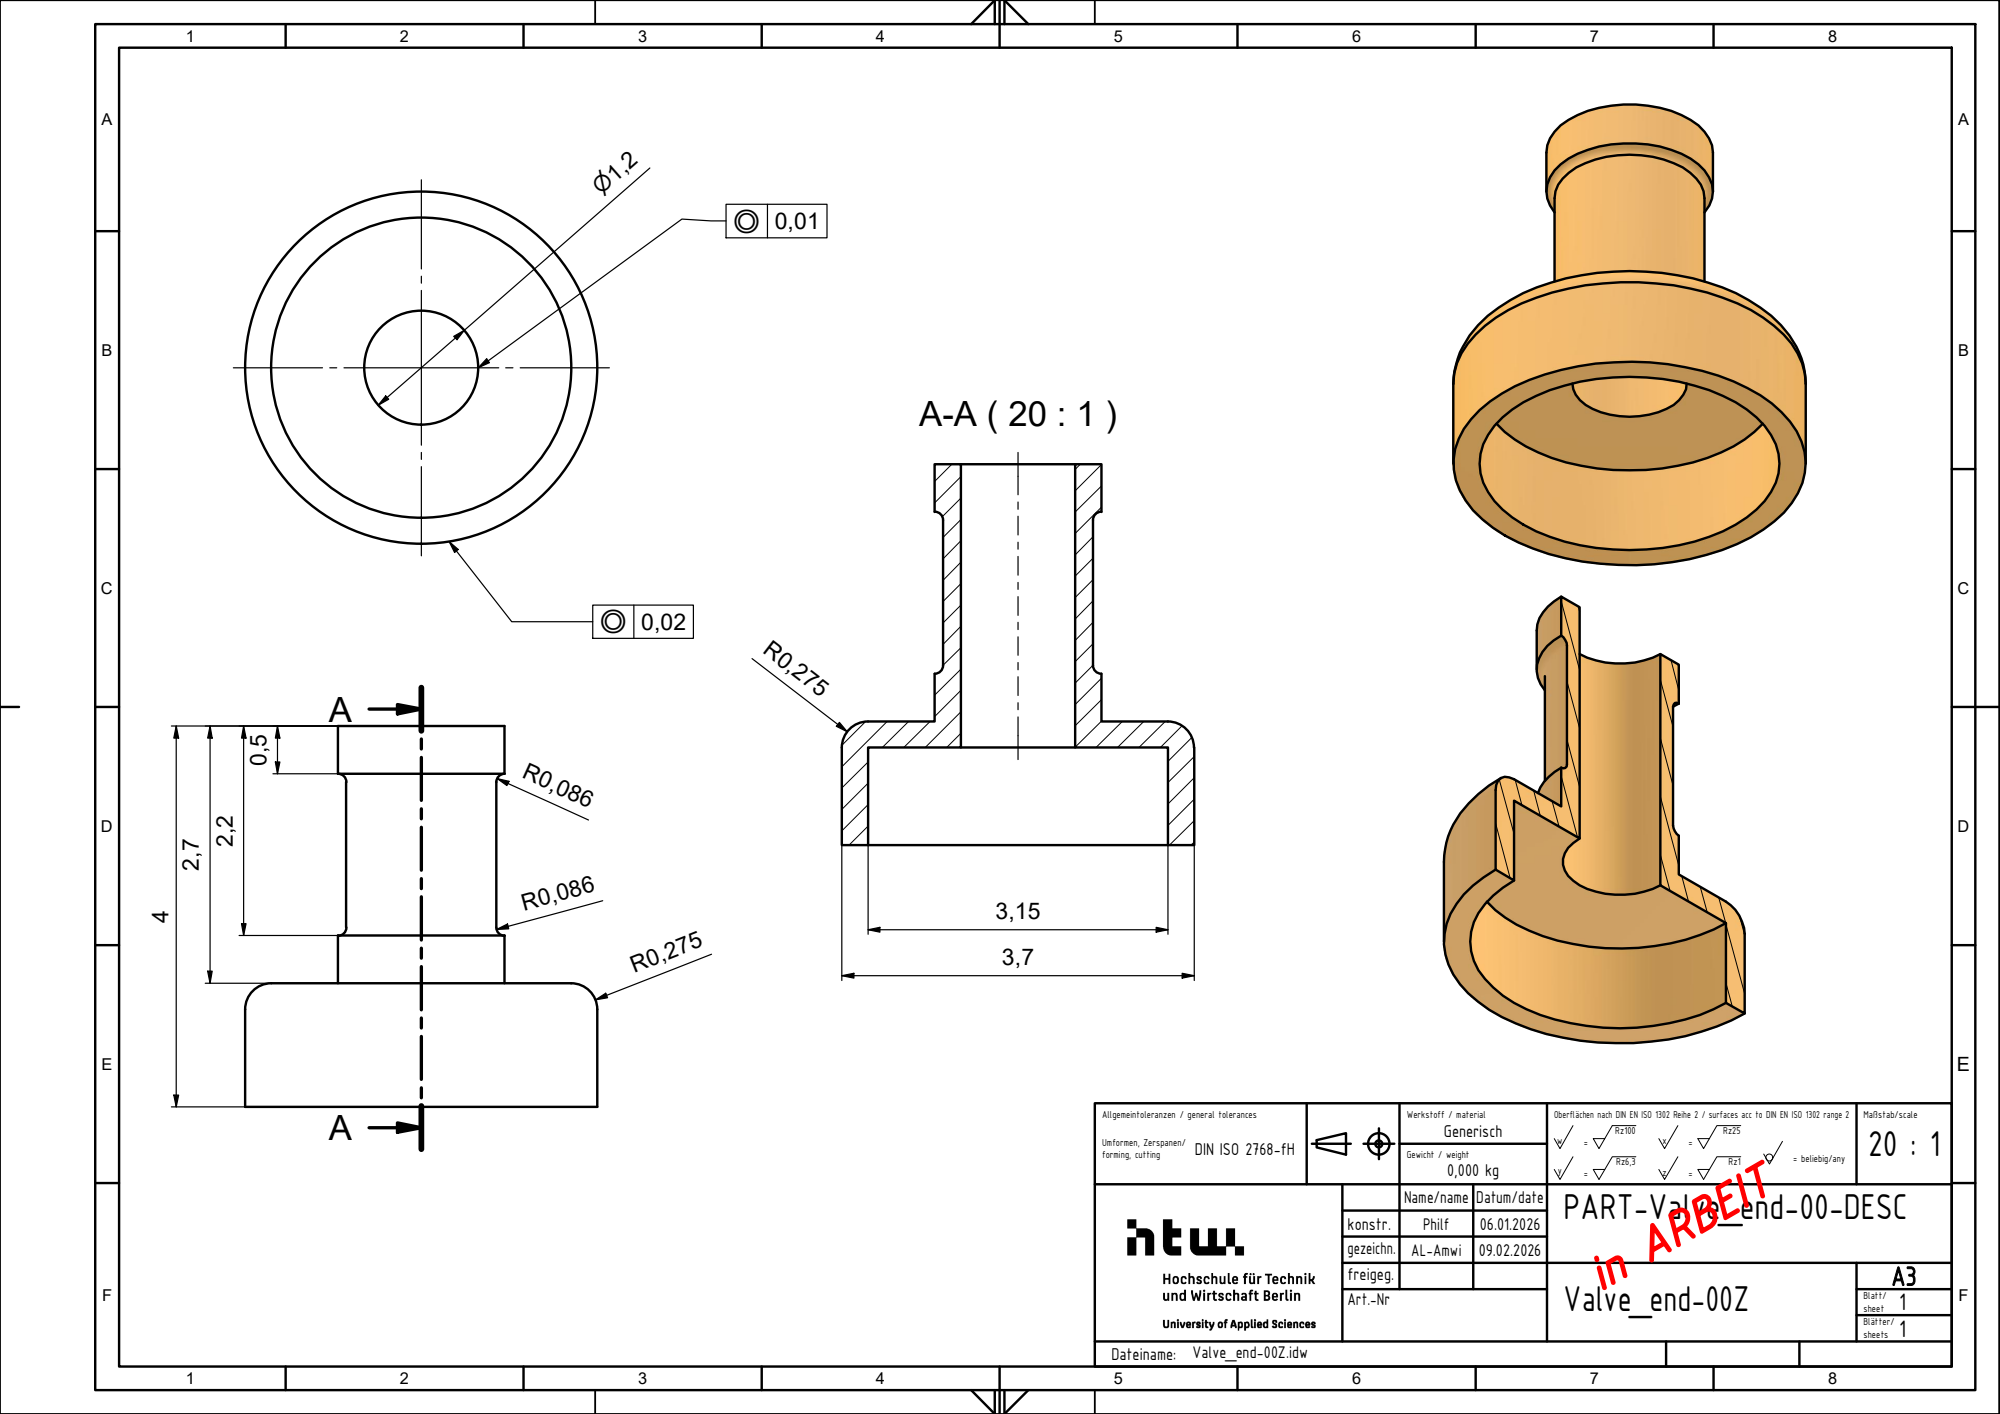
[picture p9: page 1]
Werkstoff / material; Gewicht / weight 0,000 kg; = beliebig/any; Umformen, Zerspanen/; forming, cutting; DIN ISO 2768-fH; in ARBEIT; Dateiname: Valve_end-00Z.idw

Allgemeintoleranzen / general tolerances

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

Name/name | Datum/date | PART-Valve_end-00-DESC

konstr. | Philf | 06.01.2026
gezeichn. | AL-Amwi | 09.02.2026
freigeg. | | | Valve_end-00Z | A3
Art.-Nr | | | | Blatt/ 1 sheet
