TheZyklopp/Tretboot/2D Zeichnungen/Ahmed alamwi/Valve_seat-Z1.pdf

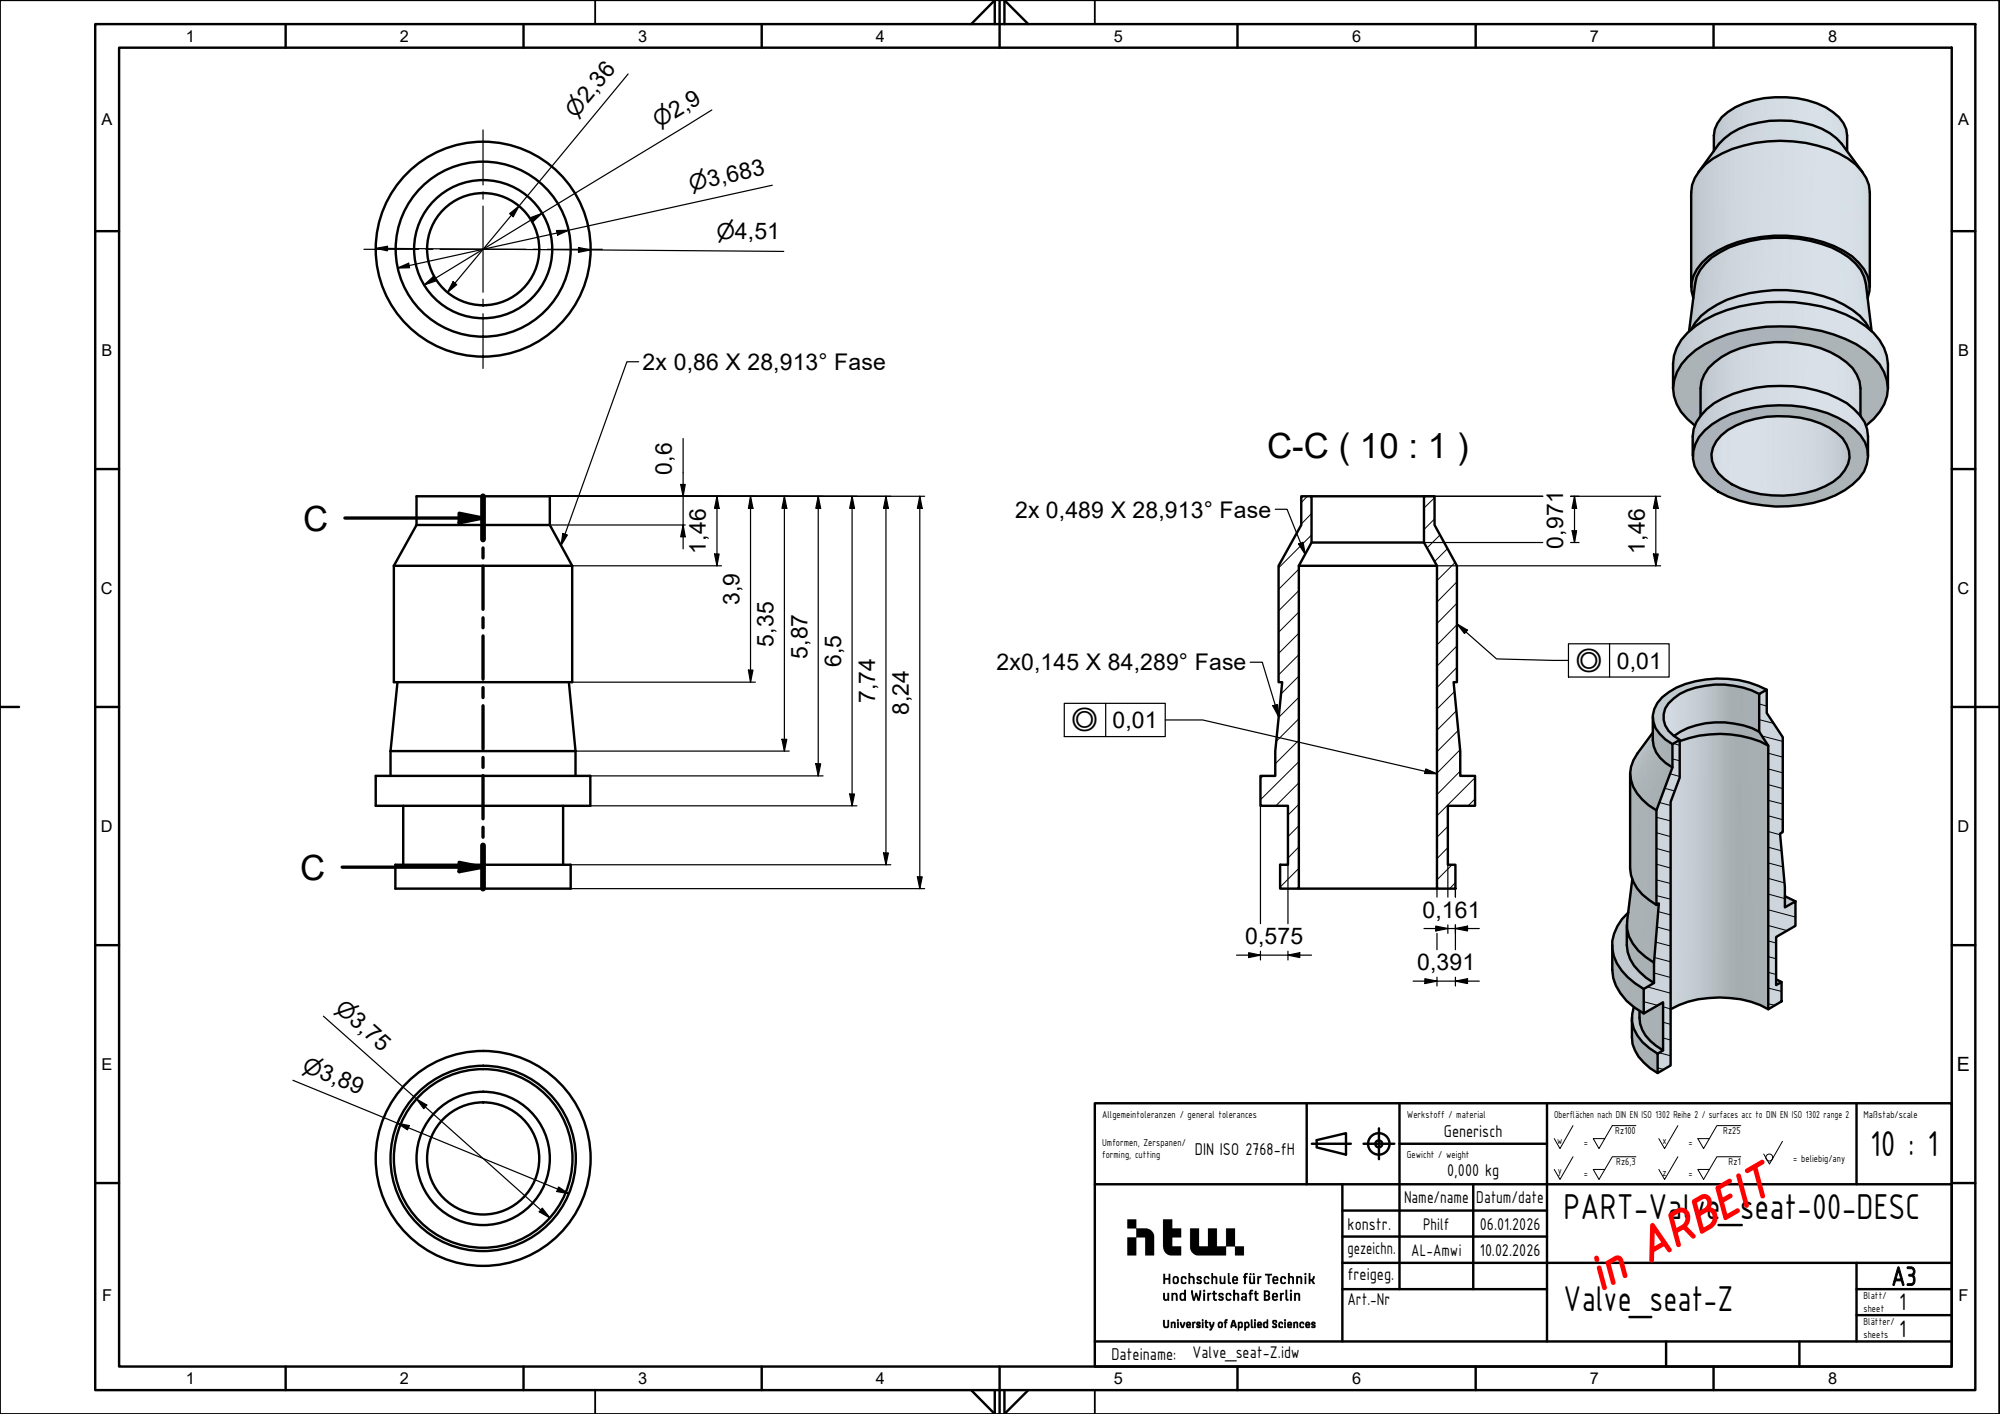
[picture p10: page 1]
Werkstoff / material; Gewicht / weight 0,000 kg; = beliebig/any; Umformen, Zerspanen/; forming, cutting; DIN ISO 2768-fH; in ARBEIT; Dateiname: Valve_seat-Z.idw; 2x 0,86 X 28,913° Fase; 2x0,145 X 84,289° Fase; 2x 0,489 X 28,913° Fase

Allgemeintoleranzen / general tolerances

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

Name/name | Datum/date | PART-Valve_seat-00-DESC

konstr. | Philf | 06.01.2026
gezeichn. | AL-Amwi | 10.02.2026
freigeg. | | | Valve_seat-Z | A3
Art.-Nr | | | | Blatt/ 1 sheet
