TheZyklopp/Tretboot/2D Zeichnungen/Julian Faber/Längs_Traverse_vorne.pdf

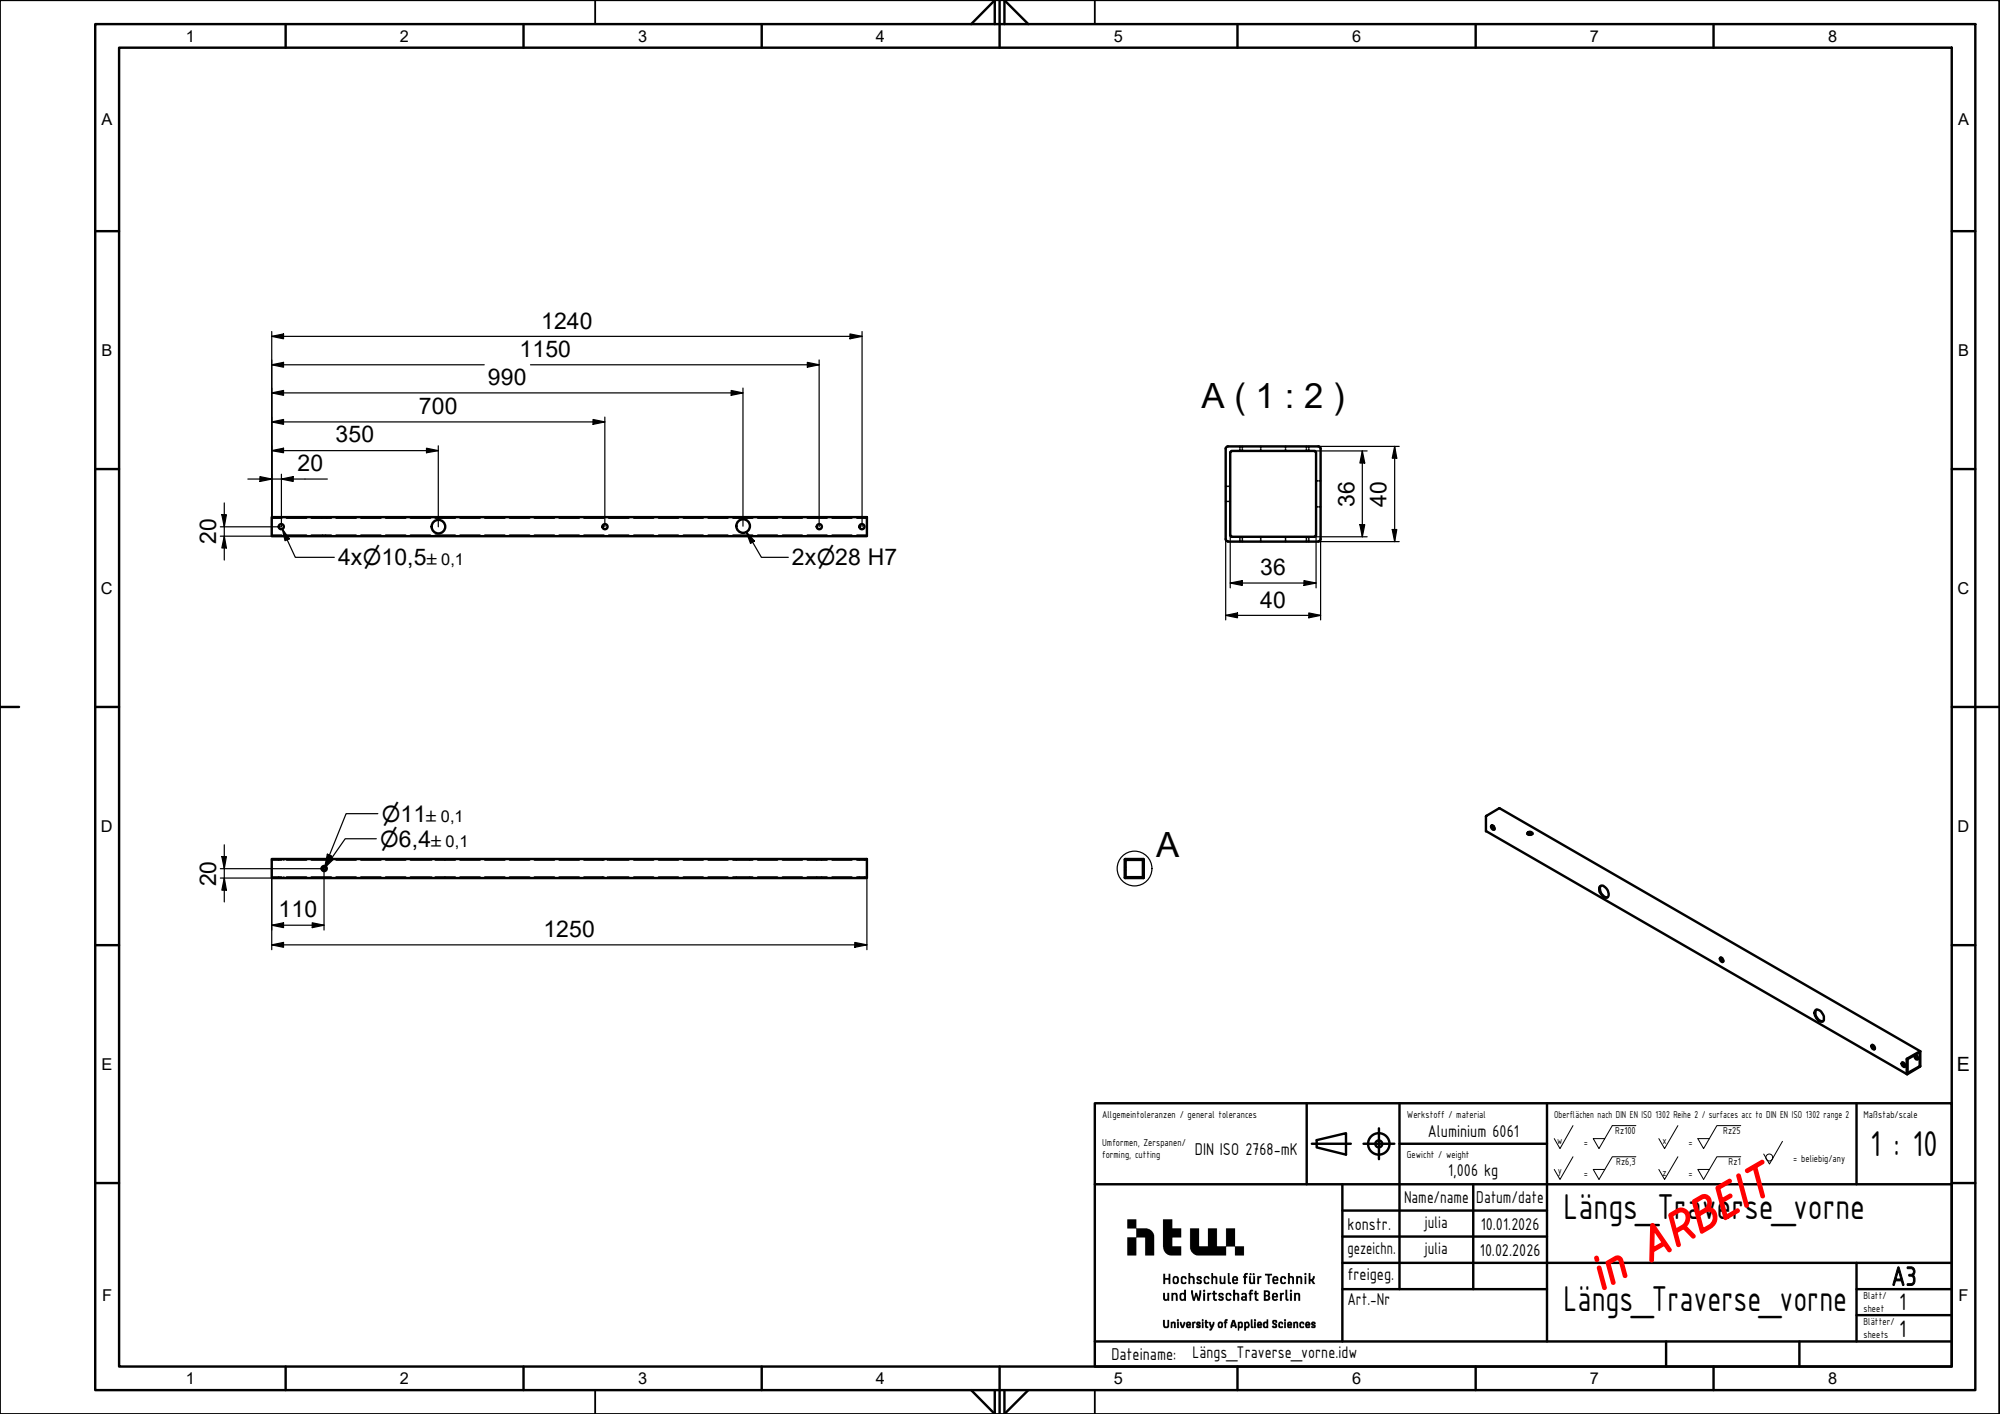
[picture p11: page 1]
Aluminium 6061; Werkstoff / material; Gewicht / weight 1,006 kg; = beliebig/any; Umformen, Zerspanen/; forming, cutting; DIN ISO 2768-mK; in ARBEIT; Dateiname: Längs_Traverse_vorne.idw

Allgemeintoleranzen / general tolerances

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

Name/name | Datum/date | Längs_Traverse_vorne

konstr. | julia | 10.01.2026
gezeichn. | julia | 10.02.2026
freigeg. | | | Längs_Traverse_vorne | A3
Art.-Nr | | | | Blatt/ 1 sheet
