TheZyklopp/Tretboot/2D Zeichnungen/Julian Faber/Quer_Traverse_Sitz.pdf

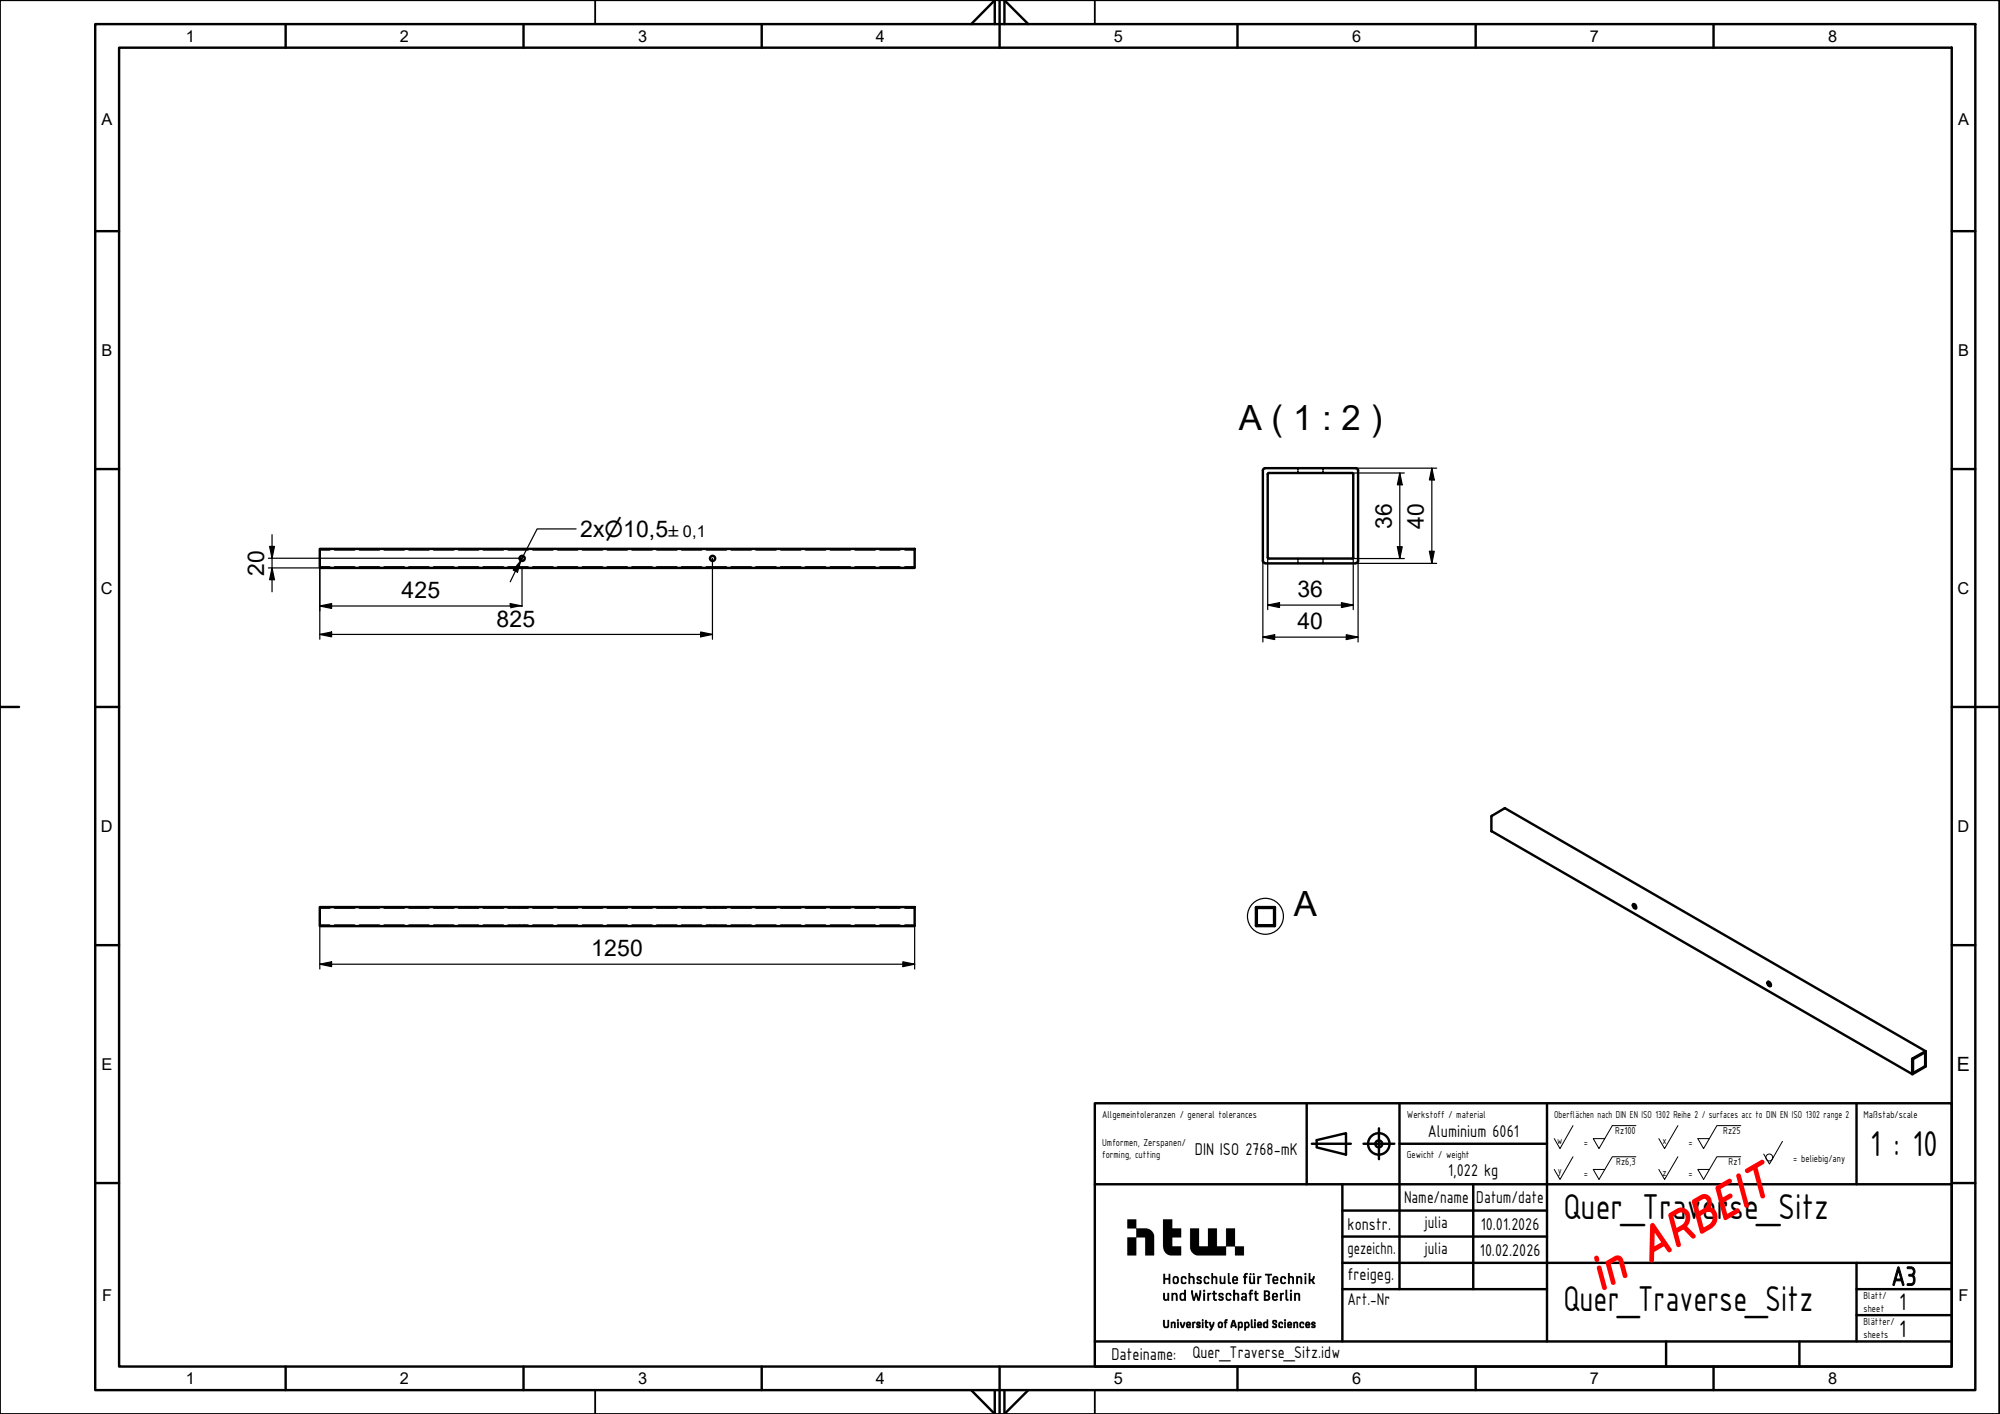
[picture p12: page 1]
Aluminium 6061; Werkstoff / material; Gewicht / weight 1,022 kg; = beliebig/any; Umformen, Zerspanen/; forming, cutting; DIN ISO 2768-mK; in ARBEIT; Dateiname: Quer_Traverse_Sitz.idw

Allgemeintoleranzen / general tolerances

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

Name/name | Datum/date | Quer_Traverse_Sitz

konstr. | julia | 10.01.2026
gezeichn. | julia | 10.02.2026
freigeg. | | | Quer_Traverse_Sitz | A3
Art.-Nr | | | | Blatt/ 1 sheet
