TheZyklopp/Tretboot/2D Zeichnungen/Julian Faber/Sitzplatte.pdf

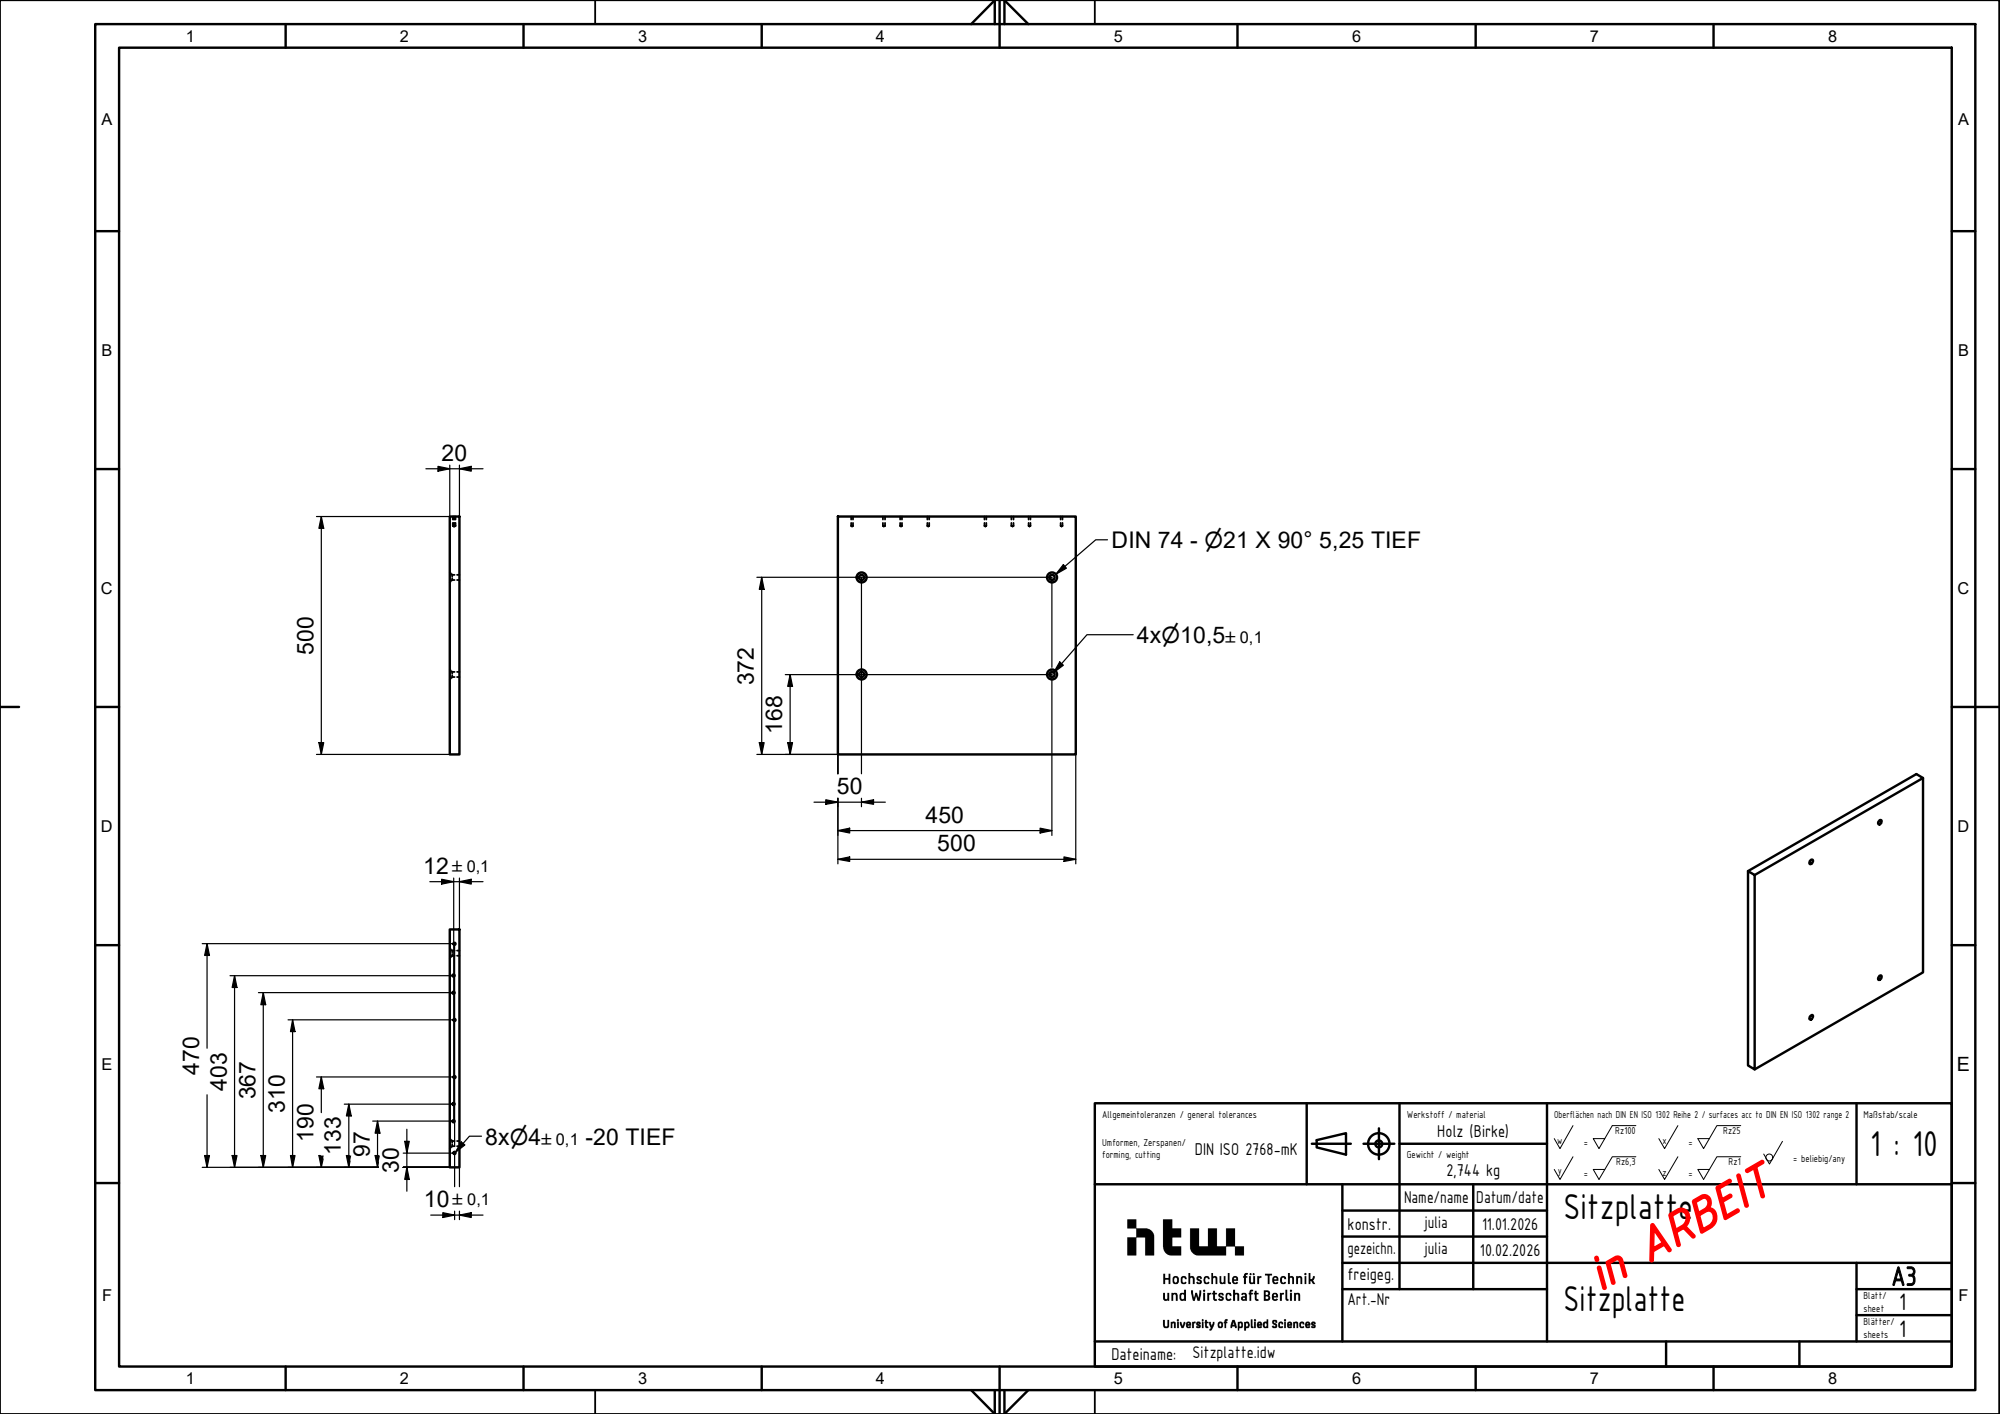
[picture p13: page 1]
Holz (Birke); Werkstoff / material; Gewicht / weight 2,744 kg; = beliebig/any; Umformen, Zerspanen/; forming, cutting; DIN ISO 2768-mK; in ARBEIT; 8x⌀4`0,1 -20 TIEF; DIN 74 - ⌀21 X 90° 5,25 TIEF

Allgemeintoleranzen / general tolerances

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

Name/name | Datum/date | Sitzplatte

konstr. | julia | 11.01.2026
gezeichn. | julia | 10.02.2026
freigeg. | | | Sitzplatte | A3
Art.-Nr | | | | Blatt/ 1 sheet

Dateiname: Sitzplatte.idw
