TheZyklopp/Tretboot/2D Zeichnungen/Julian Faber/Traversen_Deckel.pdf

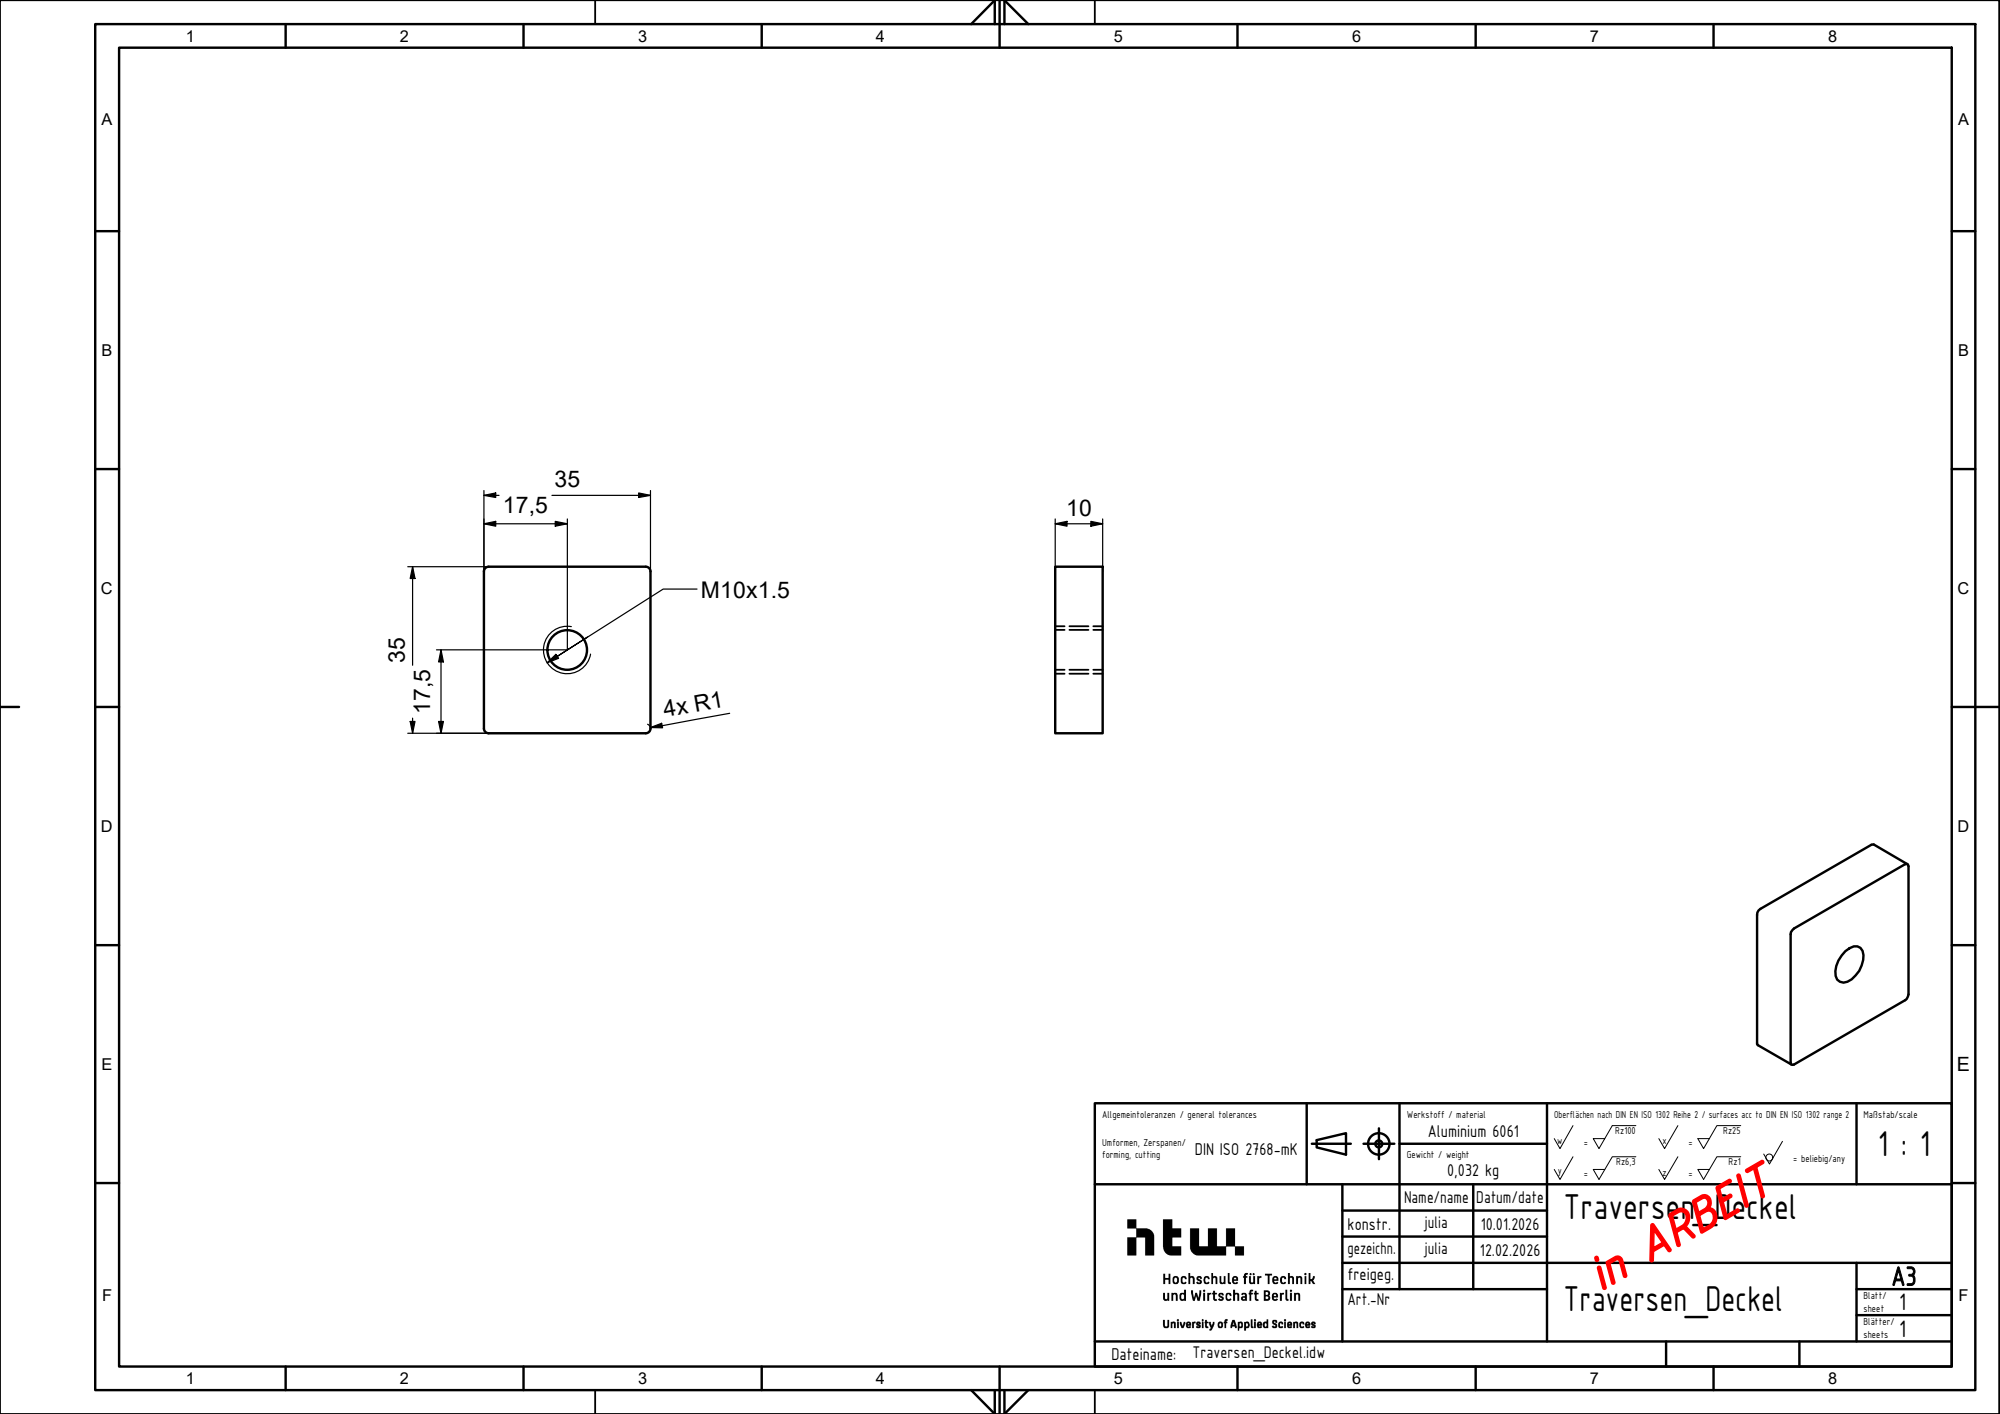
[picture p14: page 1]
Aluminium 6061; Werkstoff / material; Gewicht / weight 0,032 kg; = beliebig/any; Umformen, Zerspanen/; forming, cutting; DIN ISO 2768-mK; in ARBEIT; Dateiname: Traversen_Deckel.idw

Allgemeintoleranzen / general tolerances

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

Name/name | Datum/date | Traversen_Deckel

konstr. | julia | 10.01.2026
gezeichn. | julia | 12.02.2026
freigeg. | | | Traversen_Deckel | A3
Art.-Nr | | | | Blatt/ 1 sheet
