TheZyklopp/Tretboot/2D Zeichnungen/Philip Faber/ustück.pdf

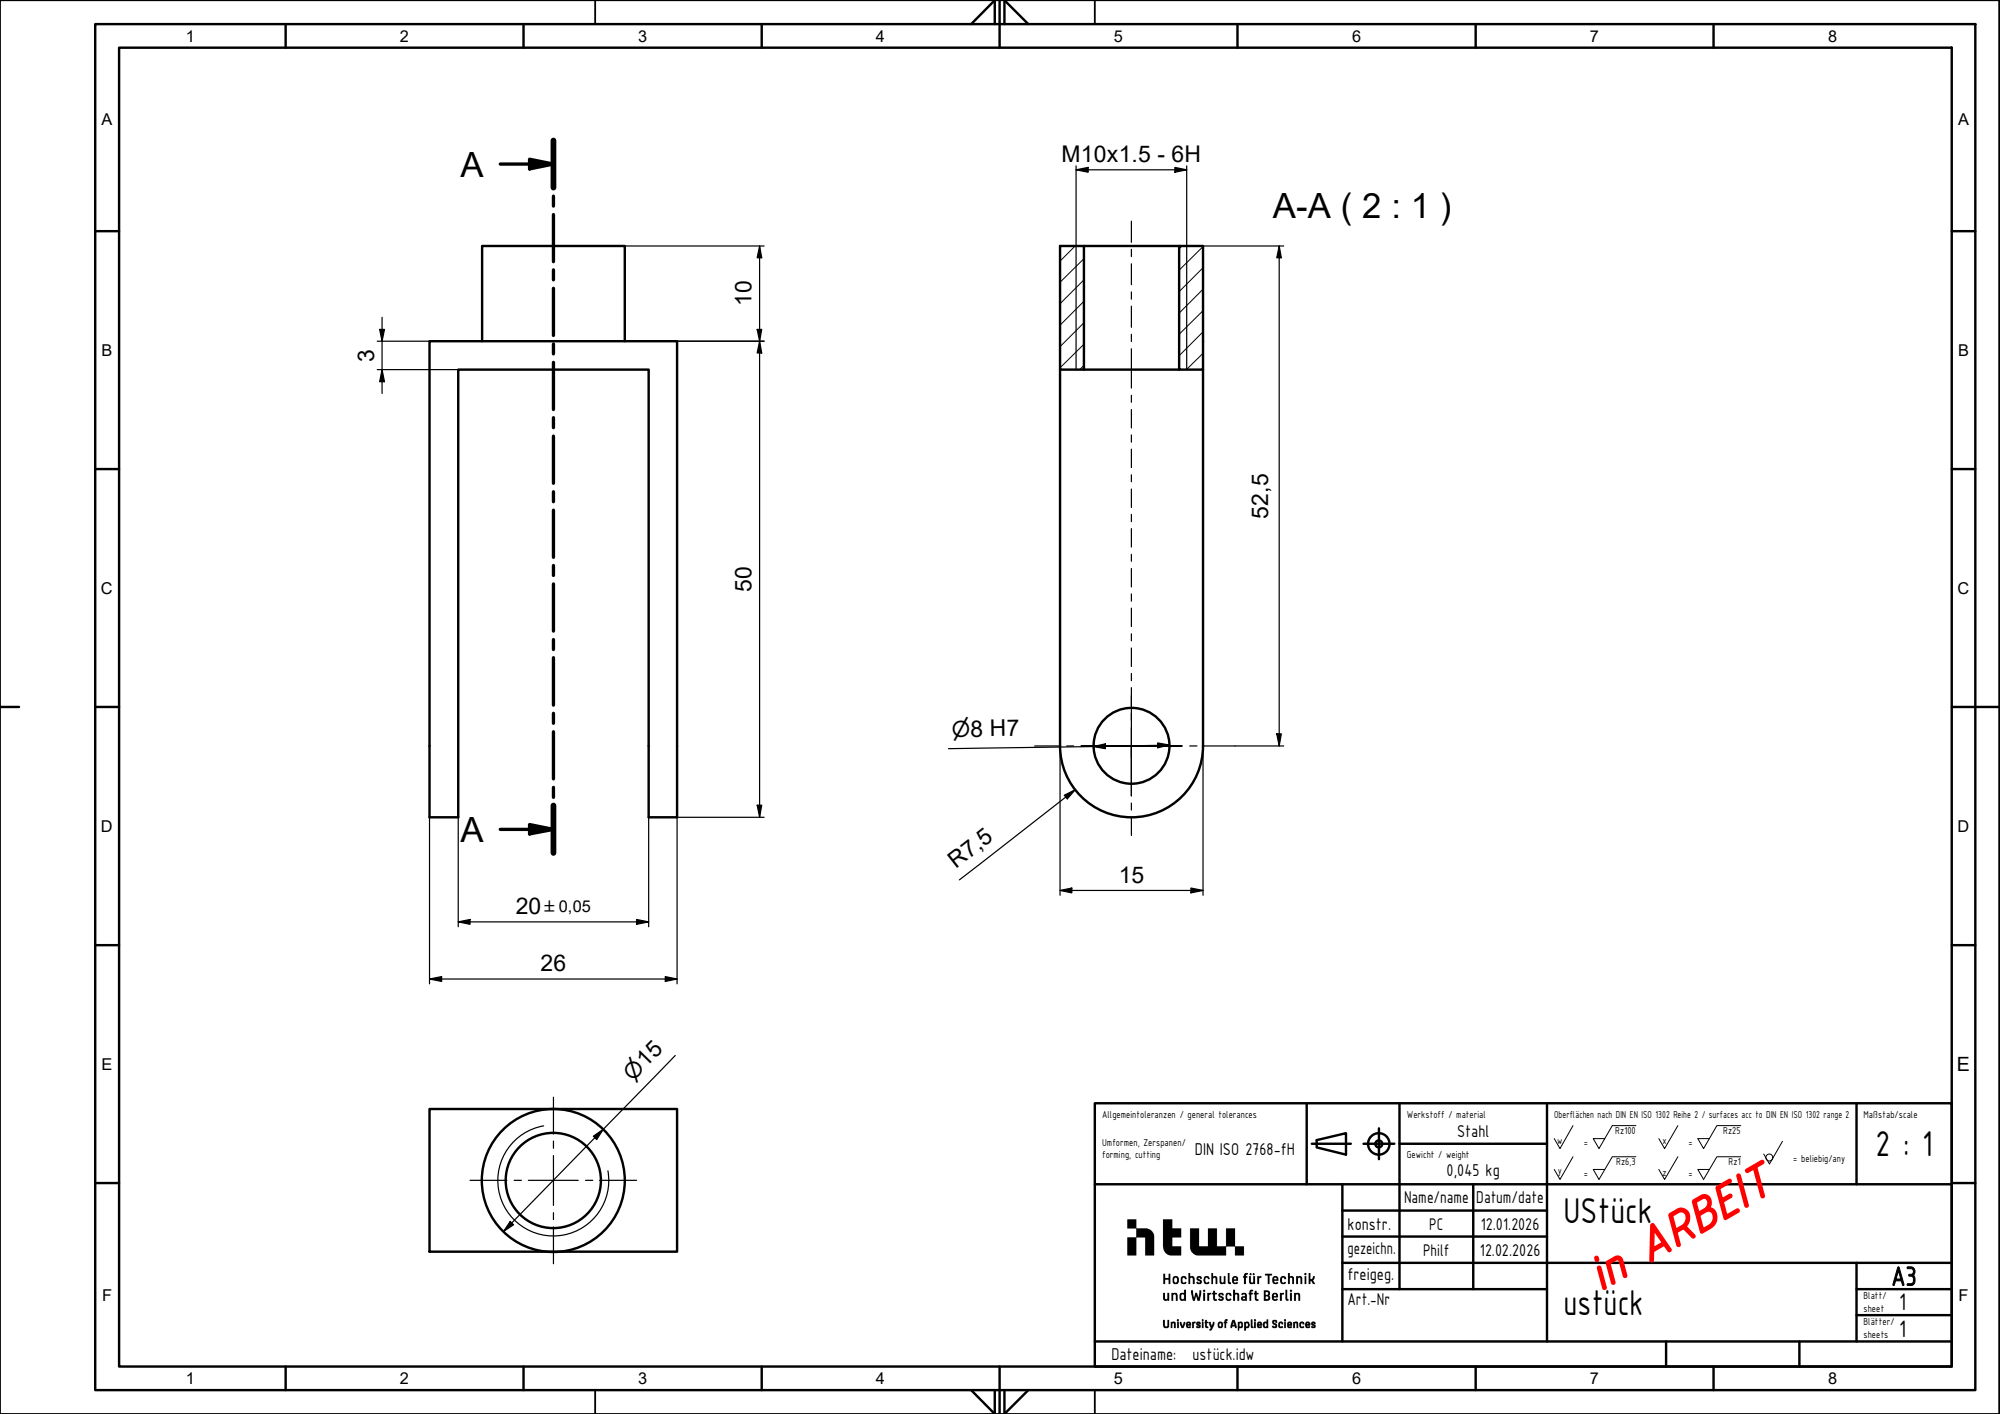
[picture p15: page 1]
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

Allgemeintoleranzen / general tolerances

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

Name/name | Datum/date | UStück

konstr. | PC | 12.01.2026
gezeichn. | Philf | 12.02.2026
freigeg. | | | ustück | A3
Art.-Nr | | | | Blatt/ 1 sheet

Dateiname: ustück.idw
