TheZyklopp/Tretboot/2D Zeichnungen/Yazan Al Hefawi/GestellVerbinder 2D von Yazan Al Hefawi 01.pdf

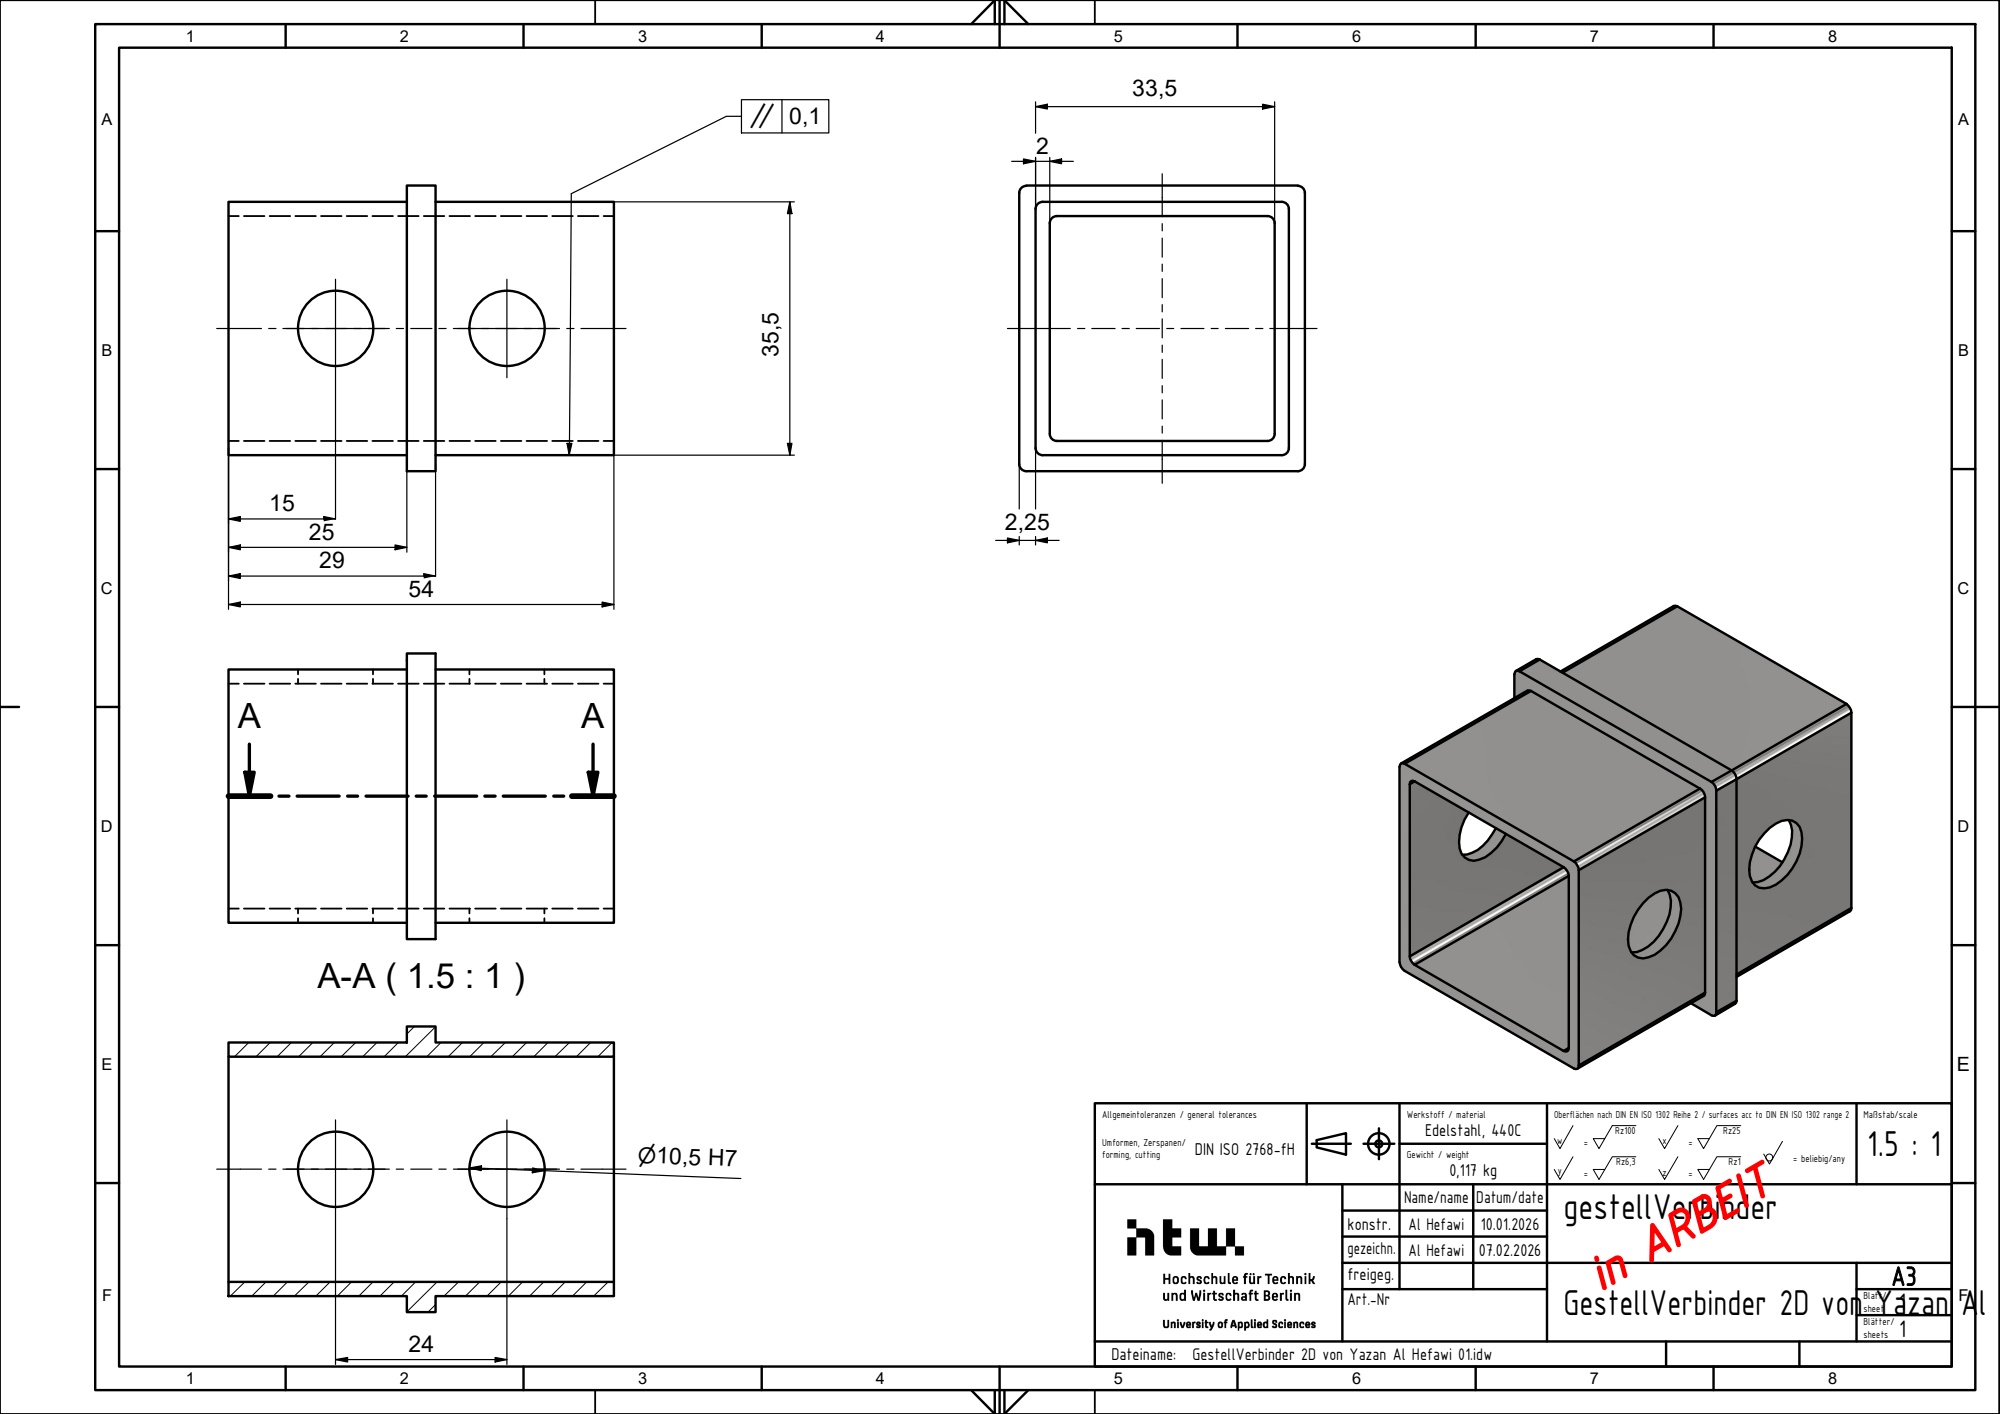
[picture p16: page 1]
Edelstahl, 440C; GestellVerbinder 2D von Yazan; Werkstoff / material; Gewicht / weight 0,117 kg; = beliebig/any; Umformen, Zerspanen/; forming, cutting; DIN ISO 2768-fH; in ARBEIT

Allgemeintoleranzen / general tolerances

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

Name/name | Datum/date | gestellVerbinder

konstr. | Al Hefawi | 10.01.2026
gezeichn. | Al Hefawi | 07.02.2026
freigeg. | | | | A3
Art.-Nr | | | | Blatt/ 1 sheet

Dateiname: GestellVerbinder 2D von Yazan Al Hefawi 01.idw
