TheZyklopp/Tretboot/2D Zeichnungen/Yazan Al Hefawi/Schrader_tube_18,5x7.7-1 2D von Alhefawi01.pdf

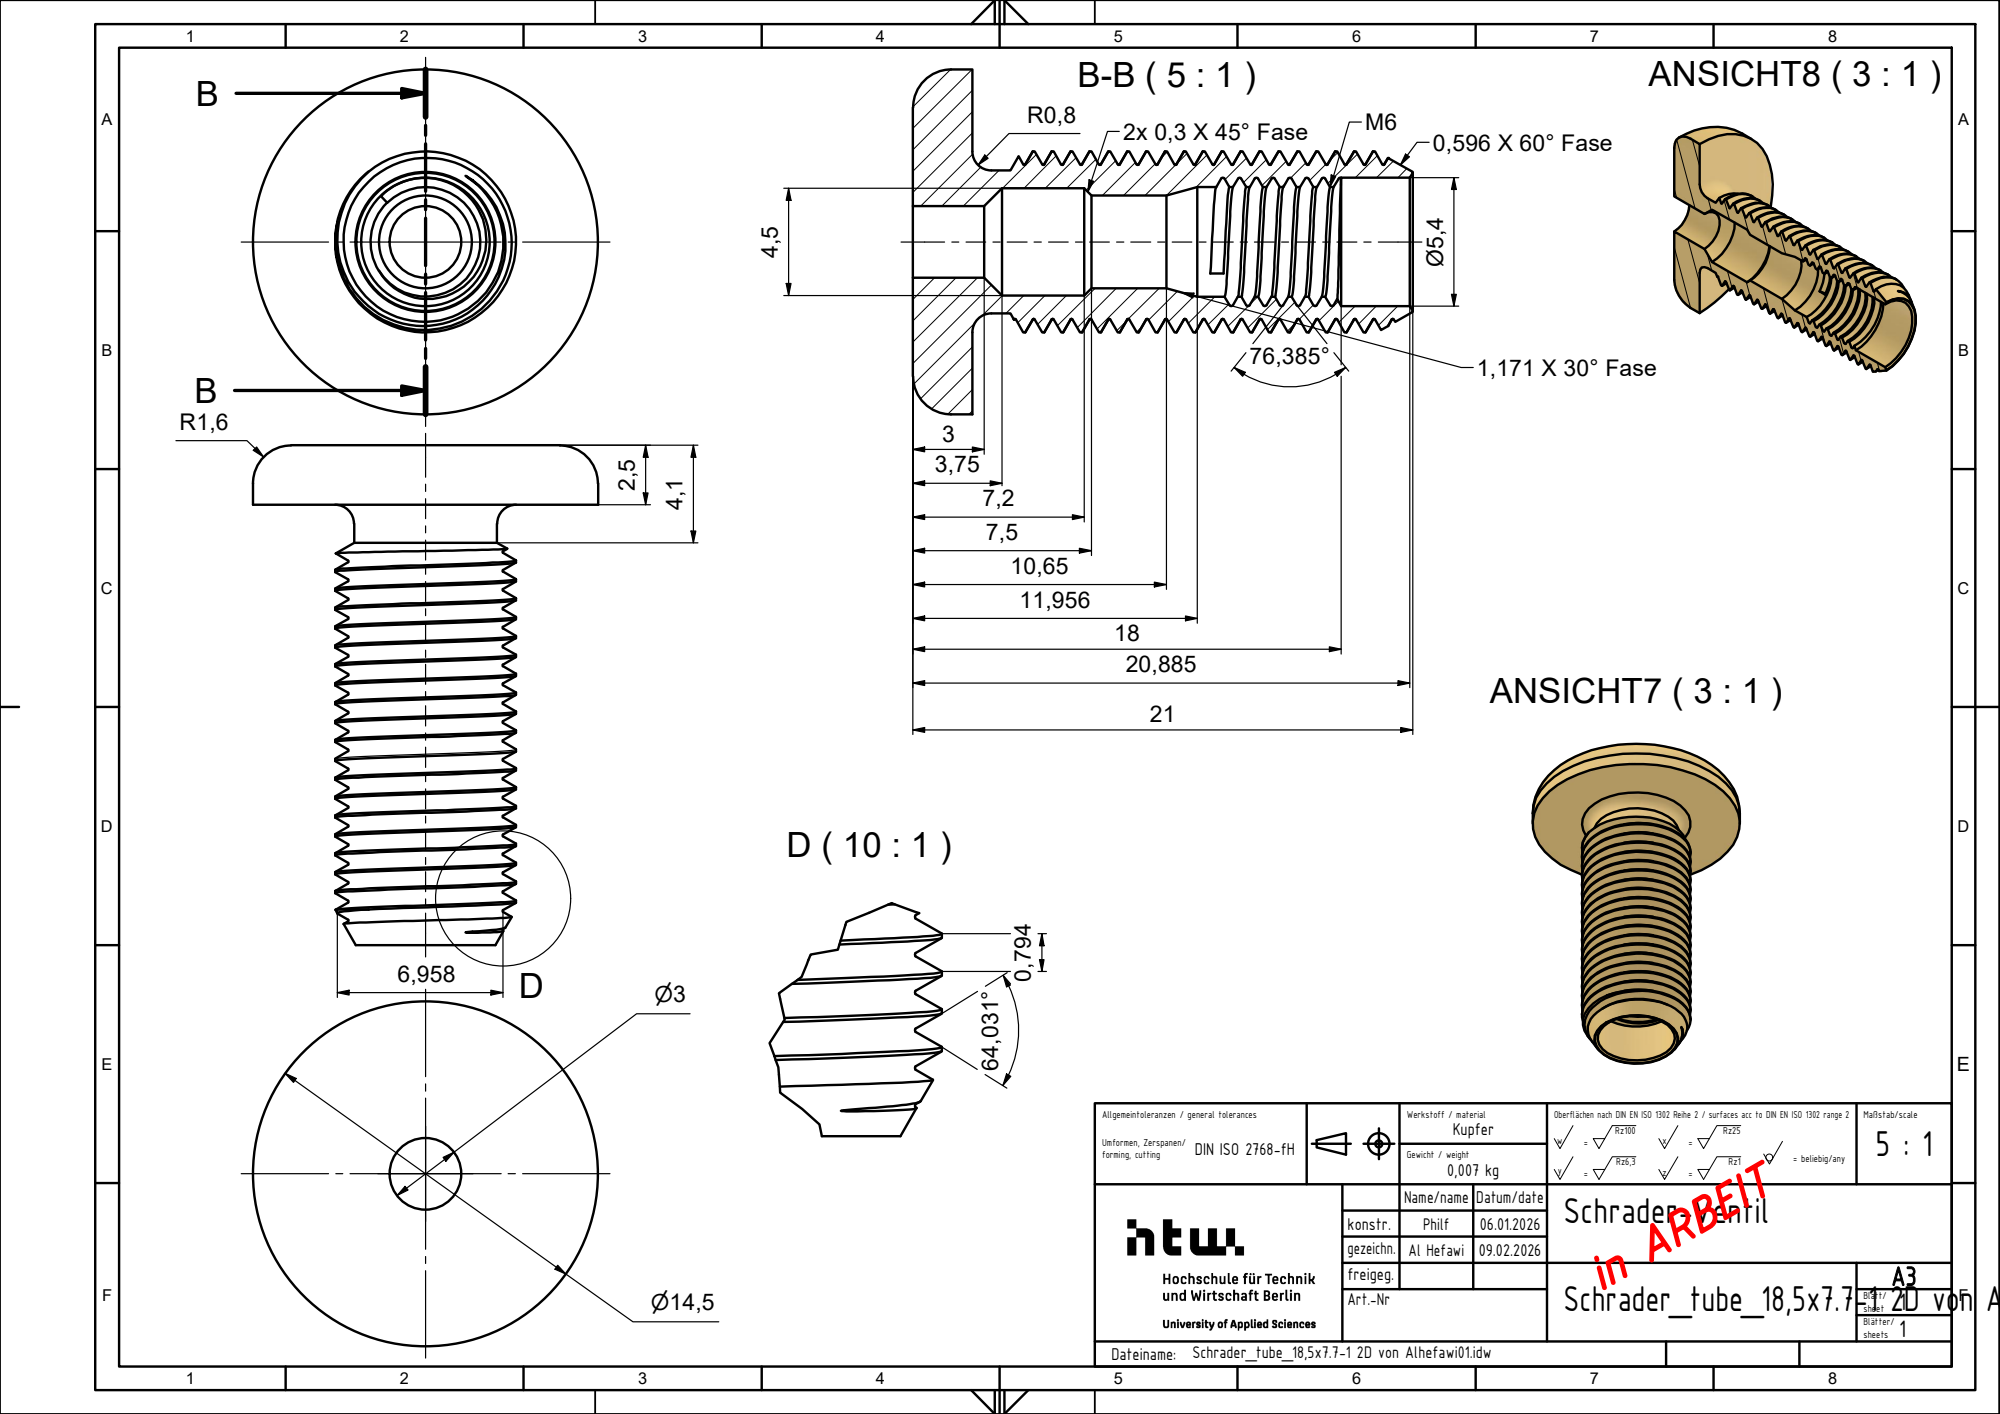
[picture p17: page 1]
ANSICHT7 ( 3 : 1 ); ANSICHT8 ( 3 : 1 ); Schrader_tube_18,5x7.7-1 2D von A; Werkstoff / material; Gewicht / weight 0,007 kg; = beliebig/any; Umformen, Zerspanen/; forming, cutting; DIN ISO 2768-fH; in ARBEIT; 0,596 X 60° Fase; 2x 0,3 X 45° Fase; 1,171 X 30° Fase

Allgemeintoleranzen / general tolerances

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

Name/name | Datum/date | Schrader-Ventil

konstr. | Philf | 06.01.2026
gezeichn. | Al Hefawi | 09.02.2026
freigeg. | | | | A3
Art.-Nr | | | | Blatt/ 1 sheet

Dateiname: Schrader_tube_18,5x7.7-1 2D von Alhefawi01.idw
