TheZyklopp/Tretboot/2D Zeichnungen/Philip Faber/Verbindung.pdf

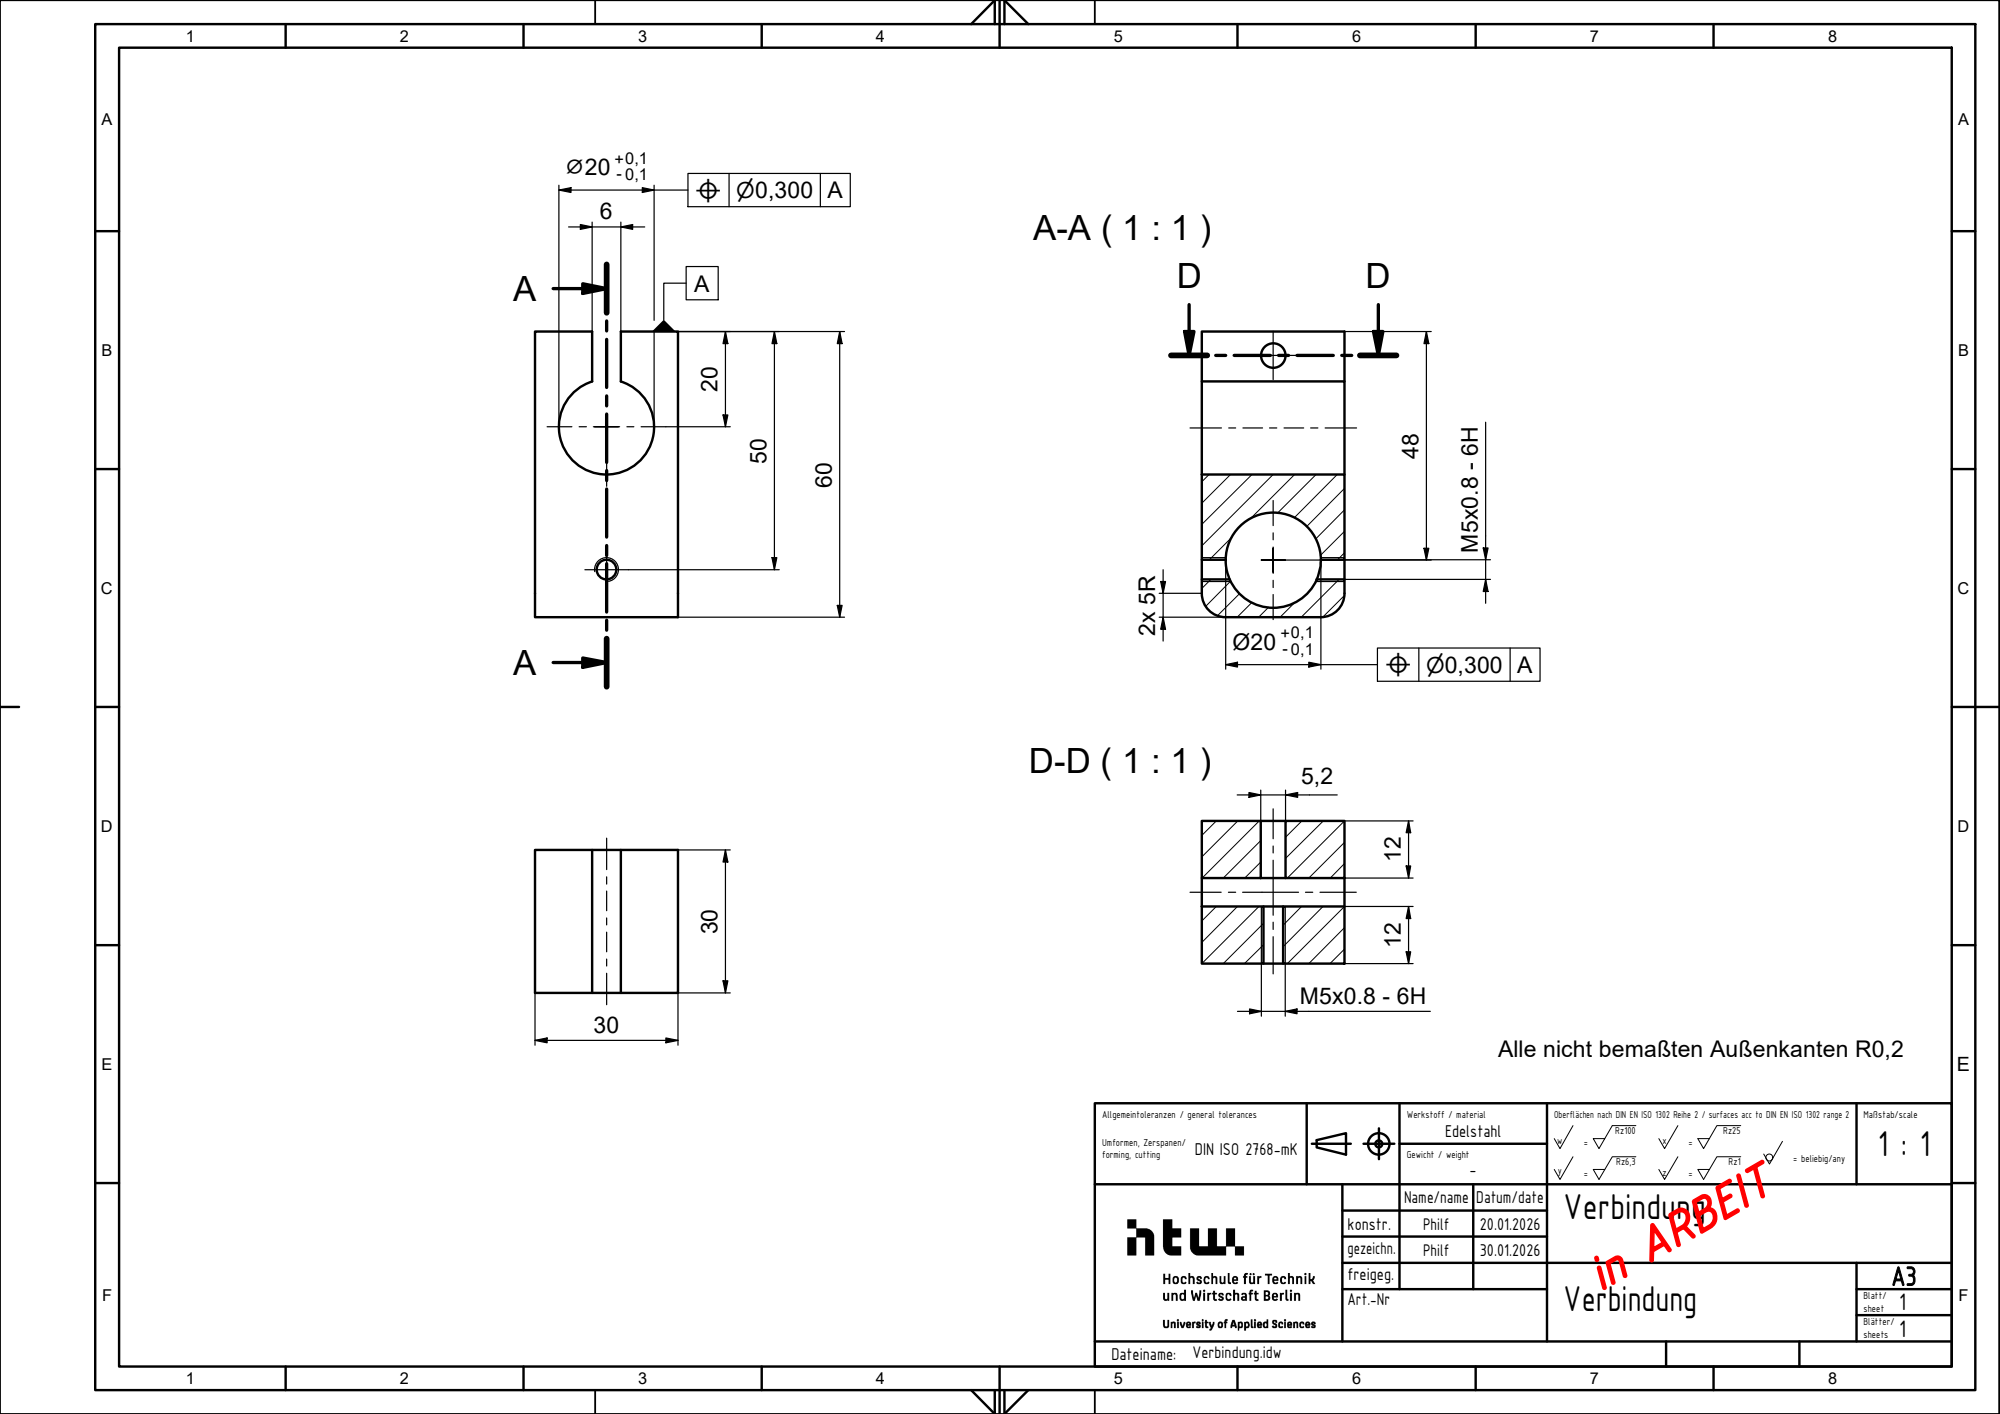
[picture p18: page 1]
Werkstoff / material; Gewicht / weight; = beliebig/any; Umformen, Zerspanen/; forming, cutting; DIN ISO 2768-mK; in ARBEIT

Alle nicht bemaßten Außenkanten R0,2

Allgemeintoleranzen / general tolerances

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

Name/name | Datum/date | Verbindung

konstr. | Philf | 20.01.2026
gezeichn. | Philf | 30.01.2026
freigeg. | | | Verbindung | A3
Art.-Nr | | | | Blatt/ 1 sheet

Dateiname: Verbindung.idw
