TheZyklopp/Tretboot/2D Zeichnungen/Yazan Al Hefawi/Verbindung-1 2D Al Hefawi 01.pdf

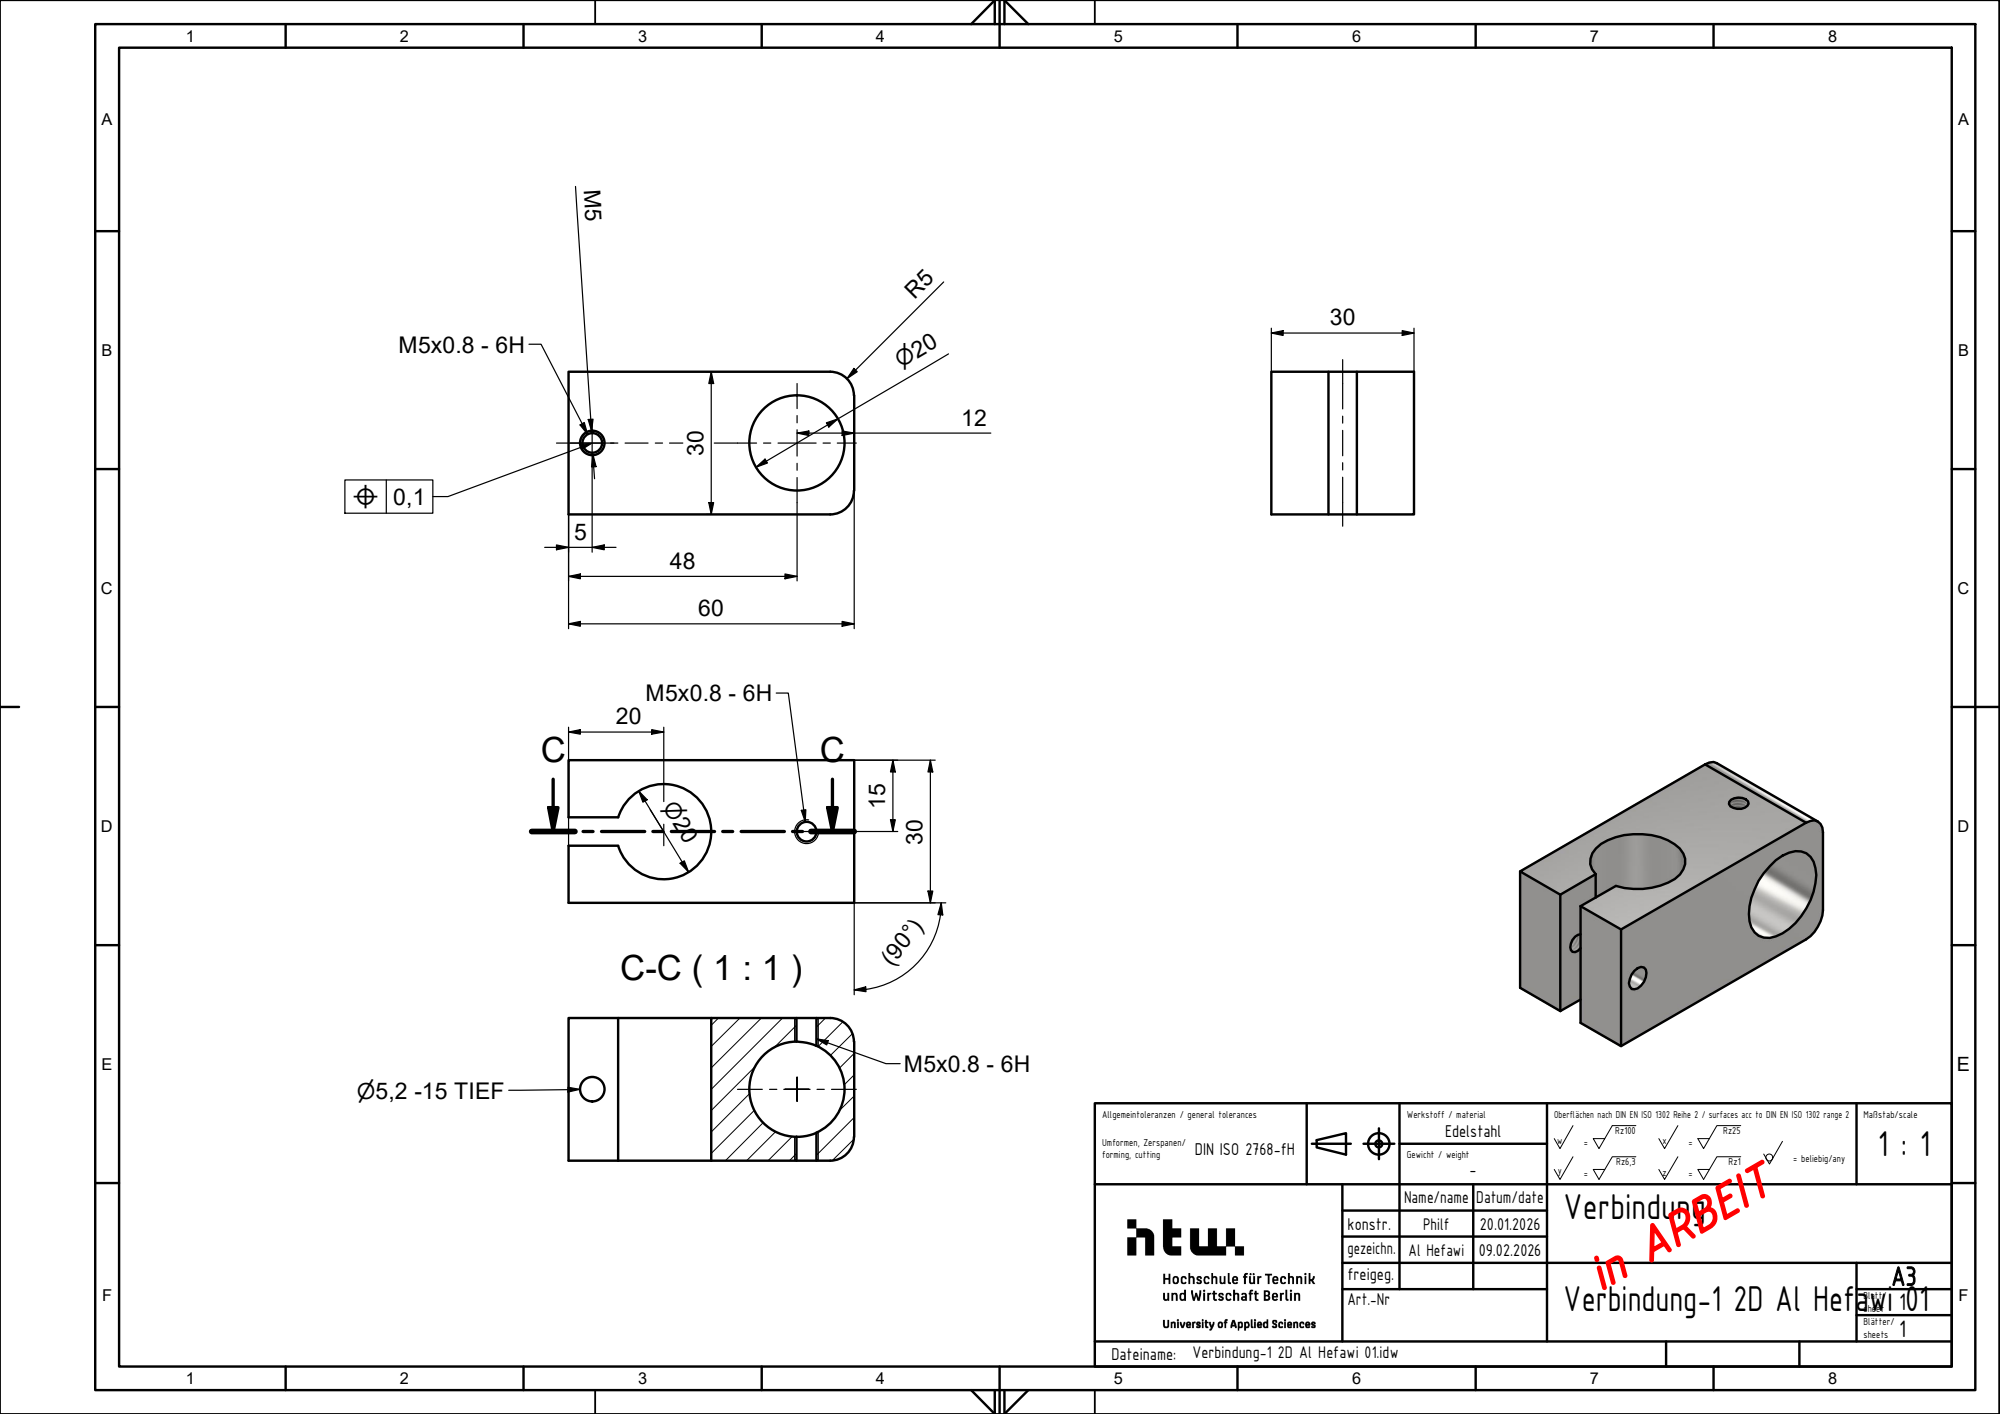
[picture p19: page 1]
Werkstoff / material; Gewicht / weight; = beliebig/any; Umformen, Zerspanen/; forming, cutting; DIN ISO 2768-fH; in ARBEIT; ⌀5,2 -15 TIEF

Allgemeintoleranzen / general tolerances

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

Name/name | Datum/date | Verbindung

konstr. | Philf | 20.01.2026
gezeichn. | Al Hefawi | 09.02.2026
freigeg. | | | Verbindung-1 2D Al Hefawi 01 | A3
Art.-Nr | | | | Blatt/ 1 sheet

Dateiname: Verbindung-1 2D Al Hefawi 01.idw
