TheZyklopp/Tretboot/Konzept/Teil1/Gruppe7-Teil1.pdf

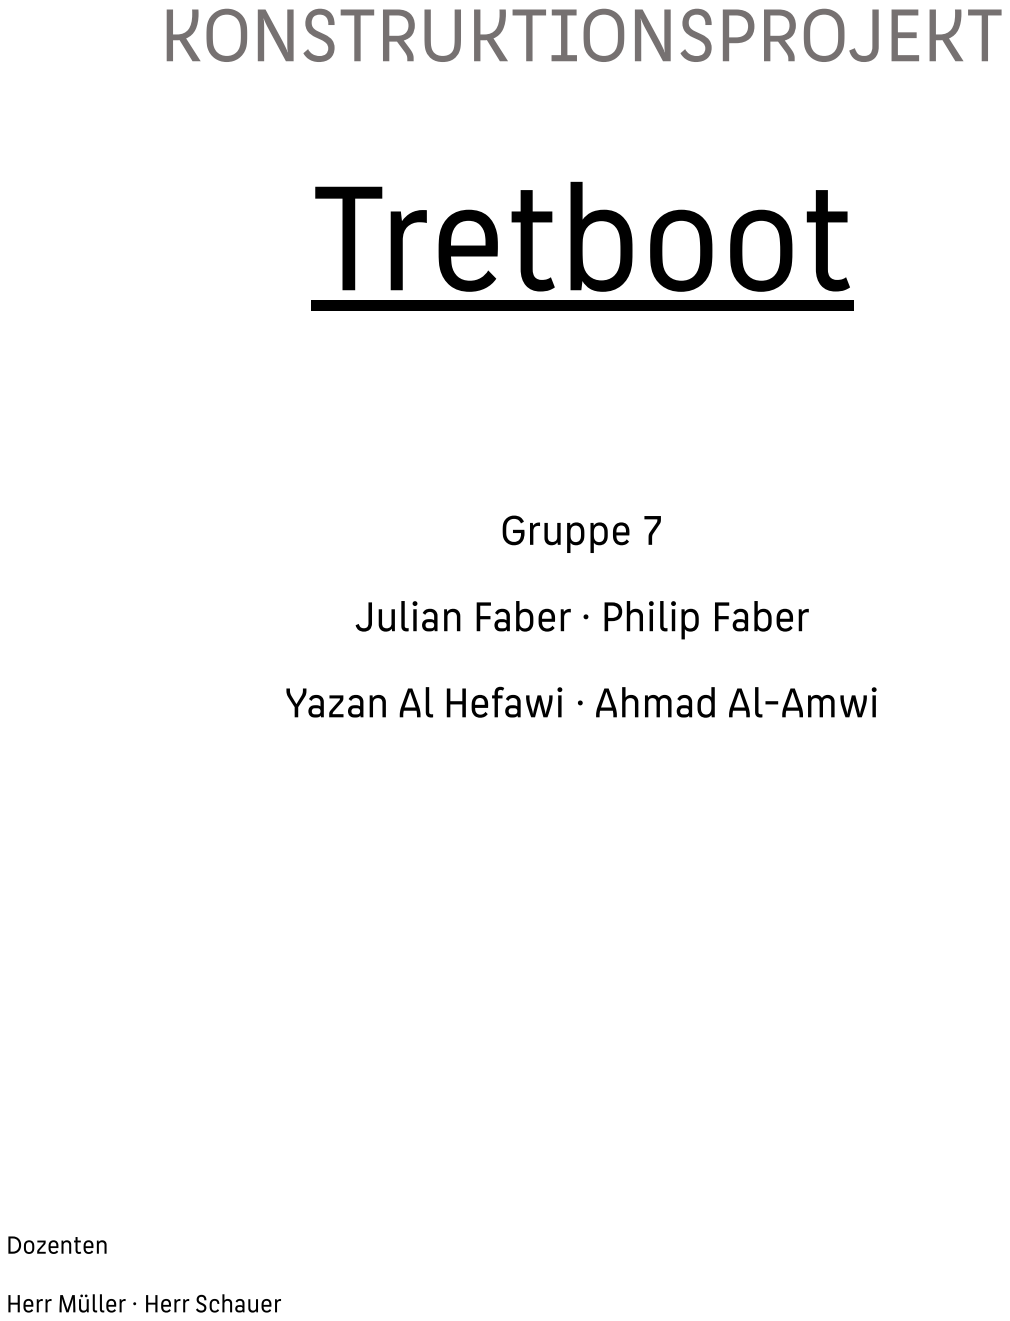
[picture p20: page 1]

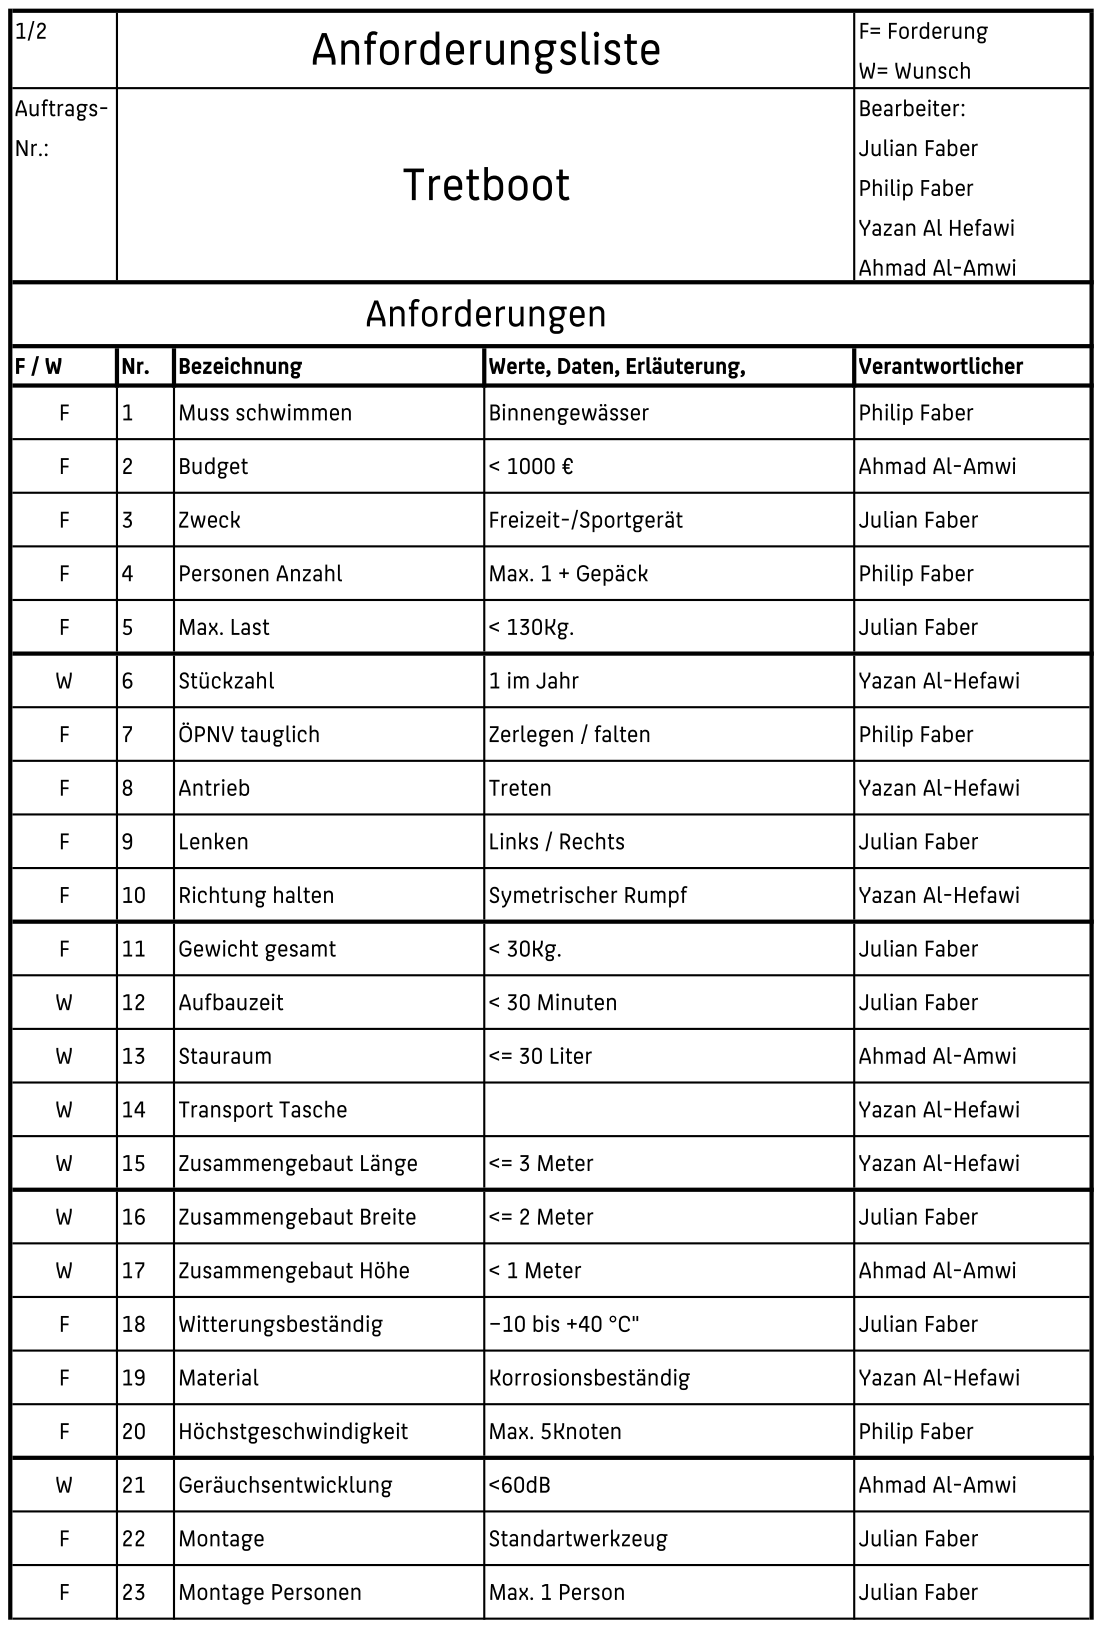
[picture p21: page 2]

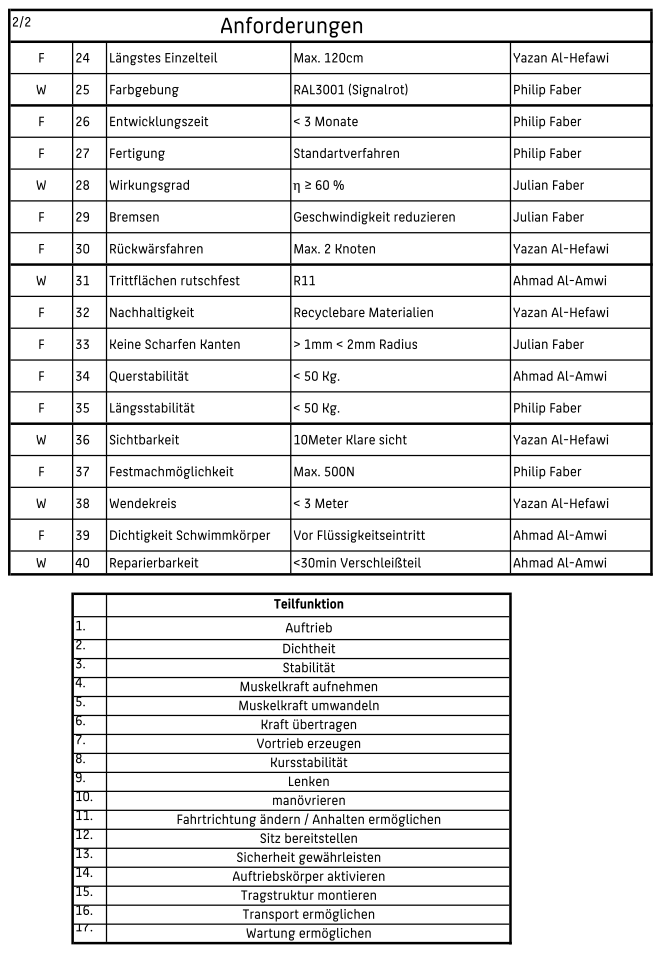
[picture p22: page 3]

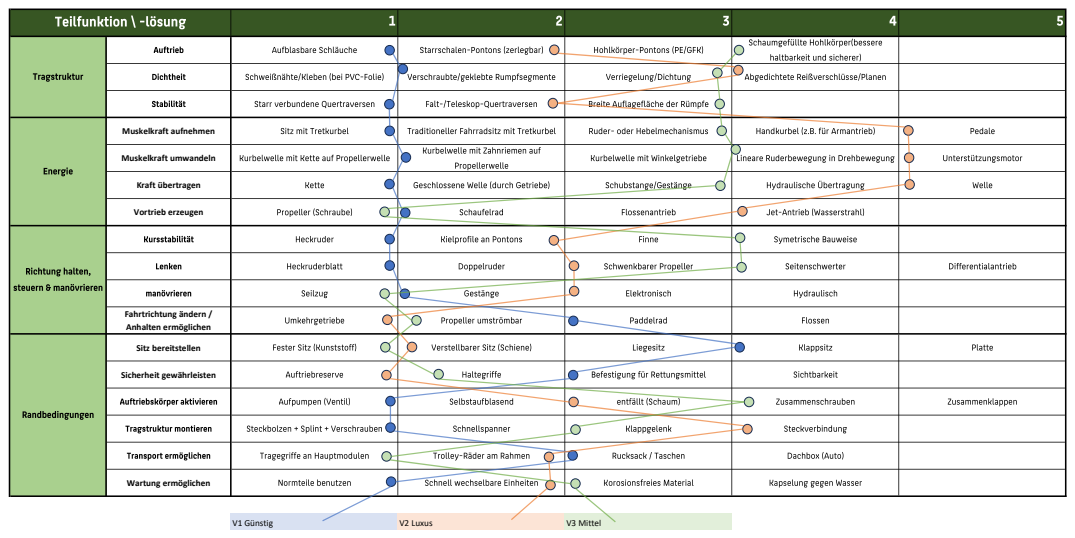
[picture p23: page 4]
Wartung ermöglichen; V1 Günstig; V2 Luxus; V3 Mittel

Muskelkraft aufnehmen

Muskelkraft umwandeln

Kraft übertragen

Vortrieb erzeugen

Fahrtrichtung ändern / Anhalten ermöglichen

Sitz bereitstellen

Sicherheit gewährleisten

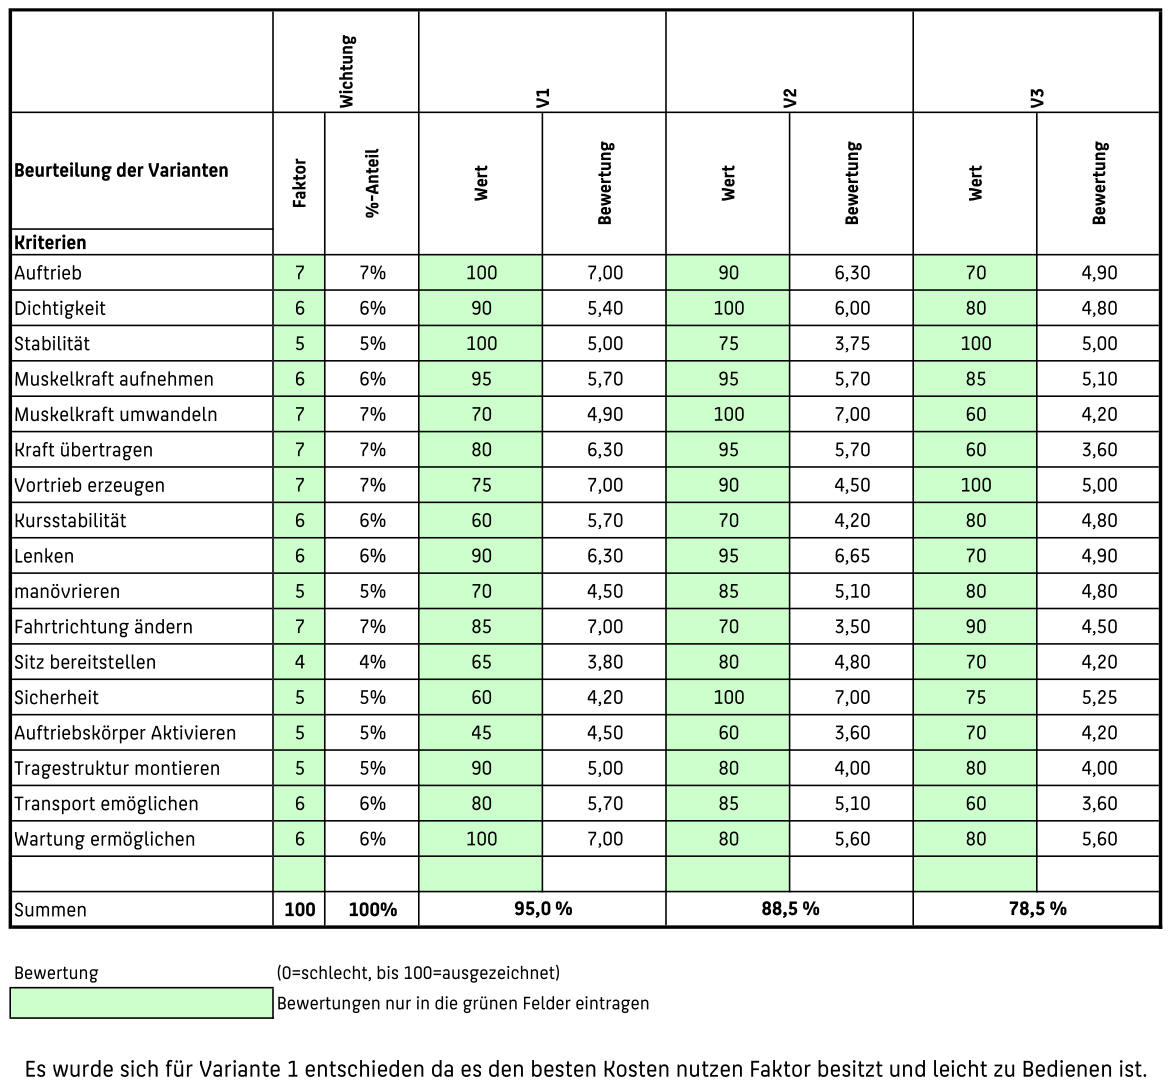
[picture p24: page 5]

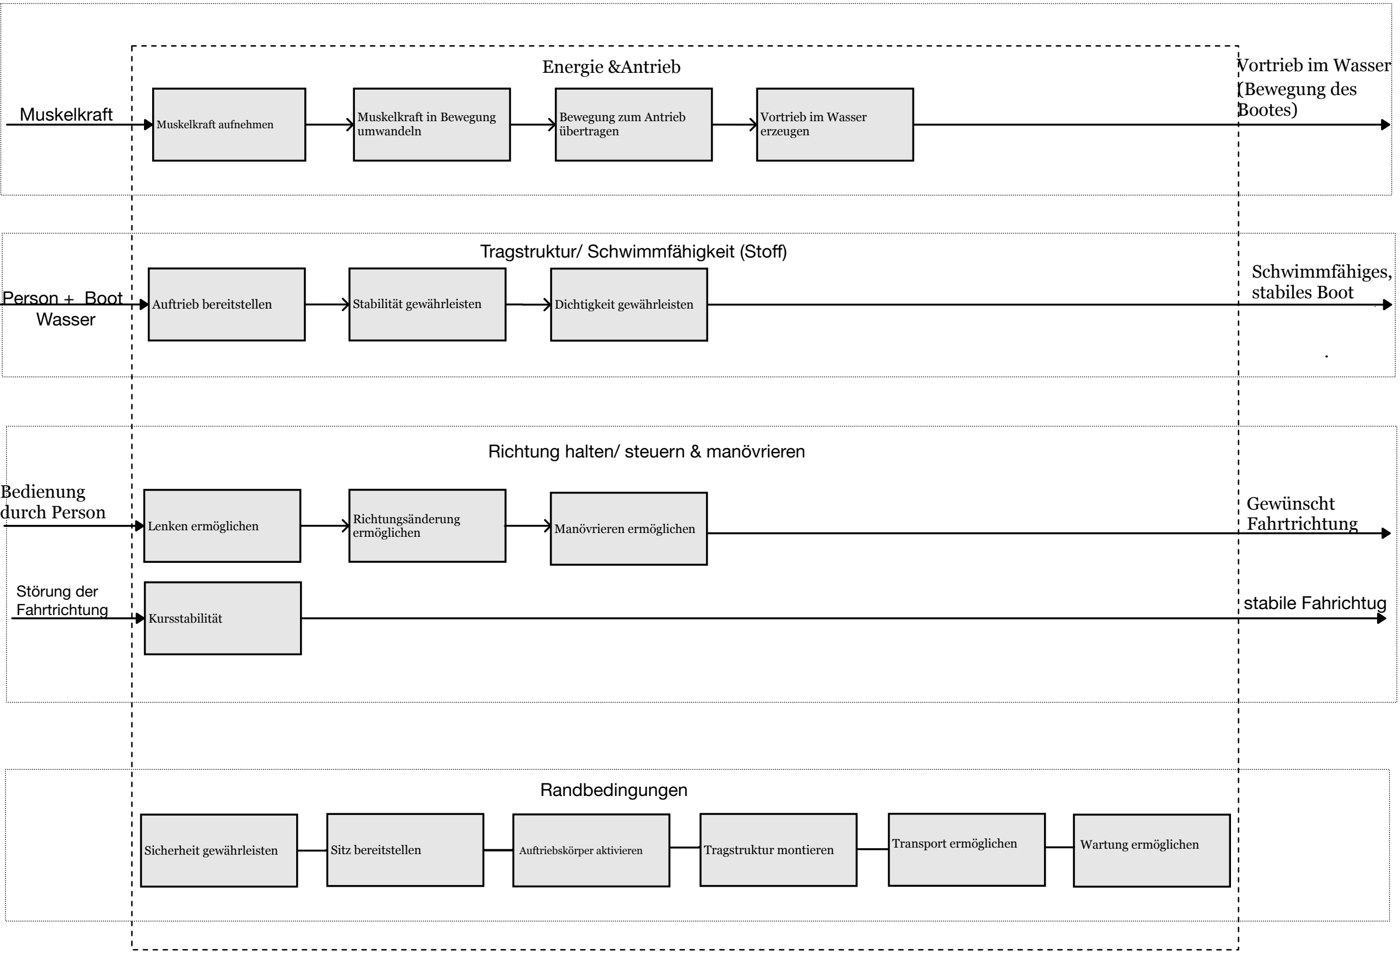
[picture p25: figure]
Muskelkraft aufnehmen; Muskelkraft in Bewegung; umwandeln; Bewegung zum Antrieb übertragen; Vortrieb im Wasser erzeugen; Auftrieb bereitstellen; Stabilität gewährleisten; Dichtigkeit gewährleisten; Lenken ermöglichen; (Bewegung des Bootes); Schwimmfähiges, stabiles Boot; Gewünscht Fahrtrichtung; Vortrieb im Wasser; Muskelkraft; Person + Boot; Bedienung durch Person; Sicherheit gewährleisten; Sitz bereitstellen; Auftriebskörper aktivieren; Richtungsänderung; ermöglichen; Manövrieren ermöglichen; Tragstruktur montieren; Transport ermöglichen; Wartung ermöglichen; Energie &Antrieb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
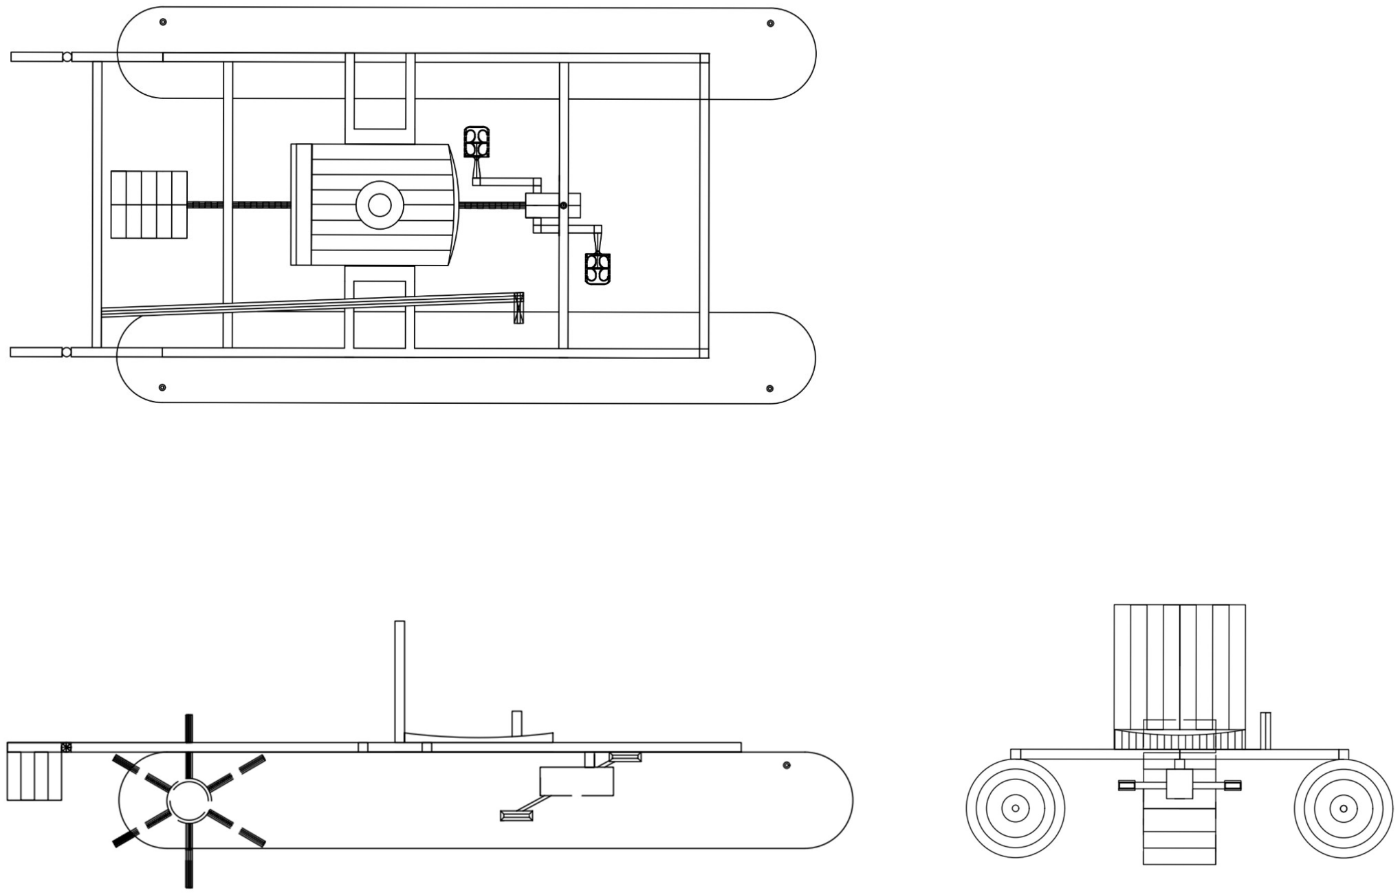
[picture p26: page 7]
