TheZyklopp/Tretboot/Konzept/Teil2/Produktarchtiktur_Gruppe7.pdf

## Antriebseinheit

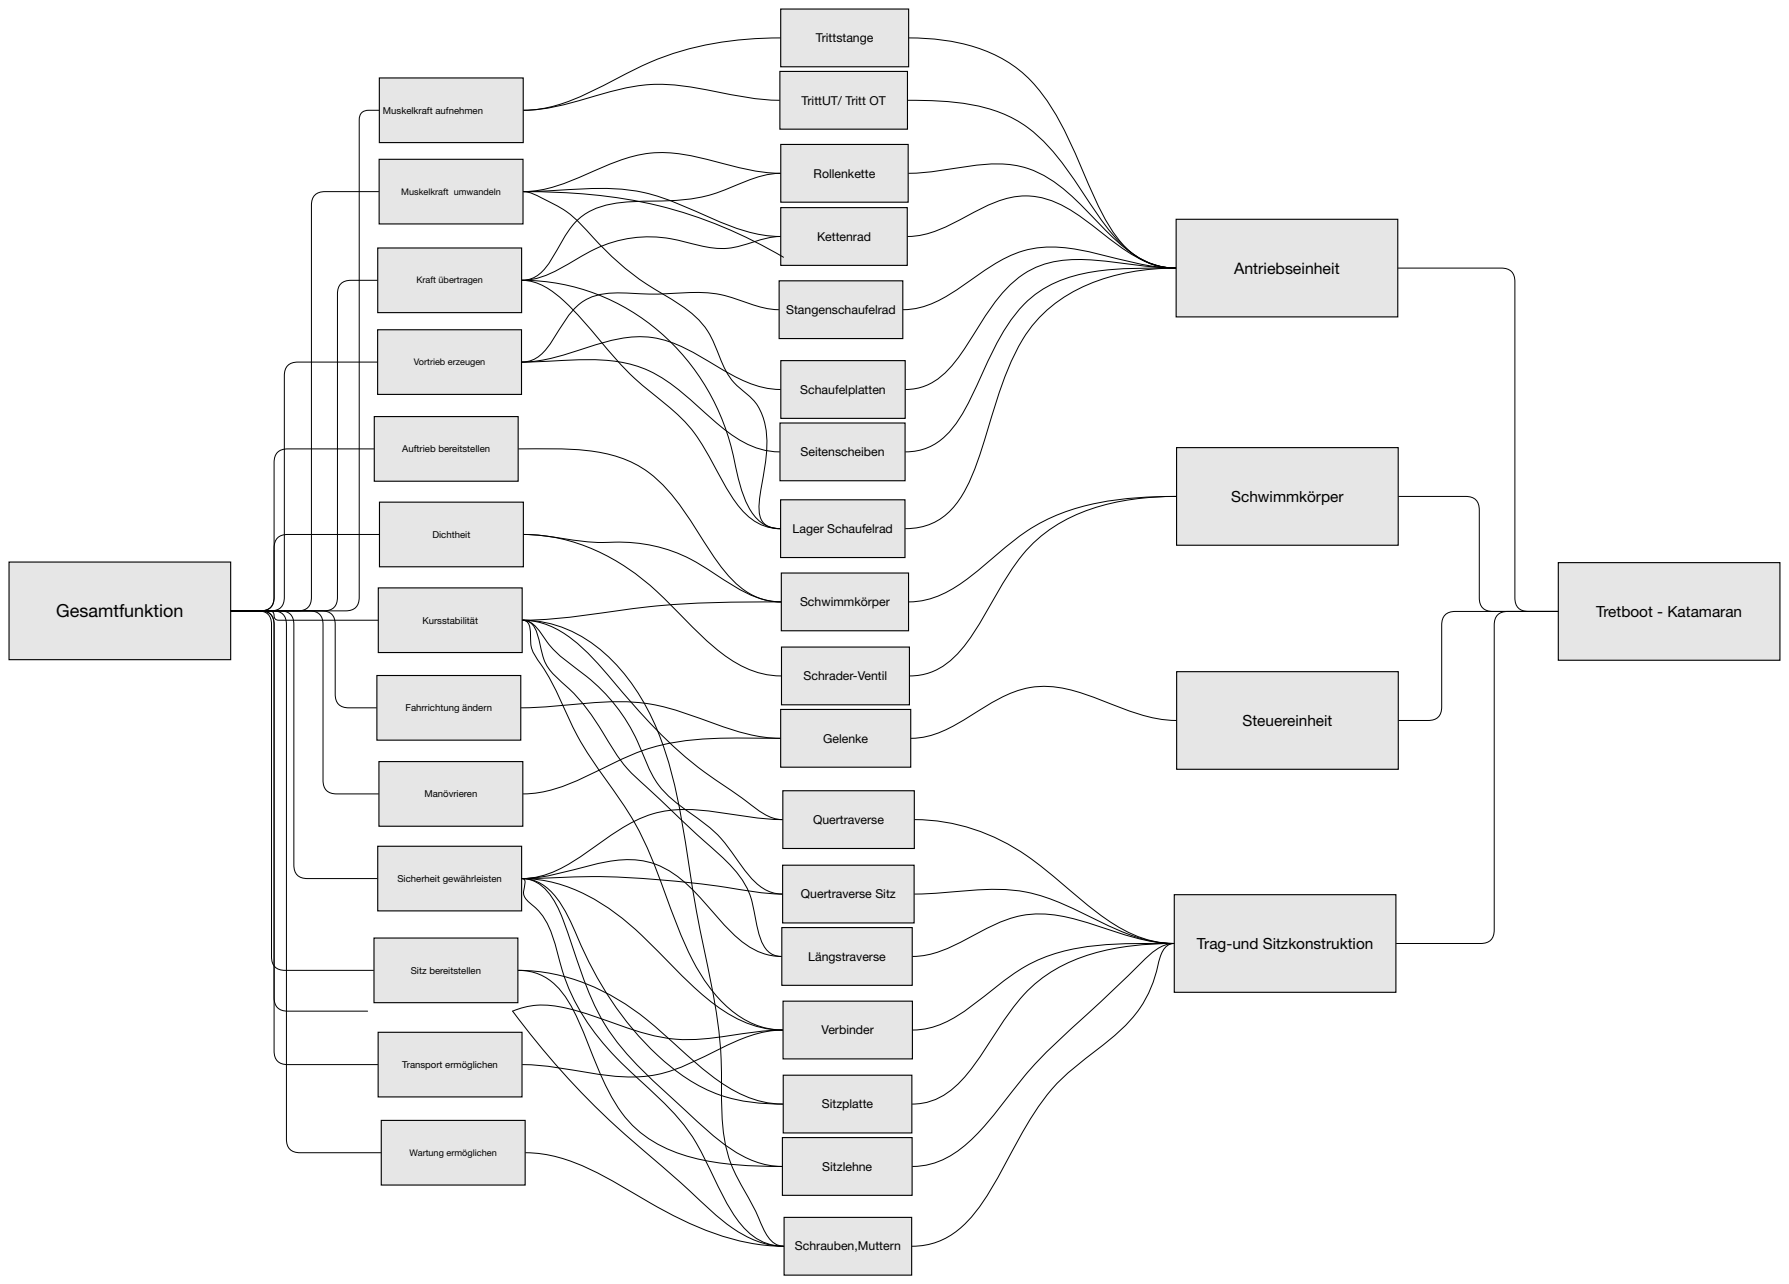
[picture p27: page 1]
Trittstange; Muskelkraft umwandeln; Kraft übertragen; Vortrieb erzeugen; Auftrieb bereitstellen; Dichtheit; Kursstabilität; Fahrrichtung ändern; Manövrieren; Sicherheit gewährleisten; Sitz bereitstellen; Rollenkette; Kettenrad; Stangenschaufelrad; Schaufelplatten; Seitenscheiben; Lager Schaufelrad; Schwimmkörper; Schrader-Ventil; Gelenke; Quertraverse; Quertraverse Sitz; Längstraverse; Verbinder; Sitzplatte; Sitzlehne; Schrauben,Muttern; Transport ermöglichen; Wartung ermöglichen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

TrittUT/ Tritt OT Muskelkraft aufnehmen

Trag-und Sitzkonstruktion
