TheZyklopp/Tretboot/Konzept/Teil2/Zusammenbau_Gruppe7.pdf

A

B

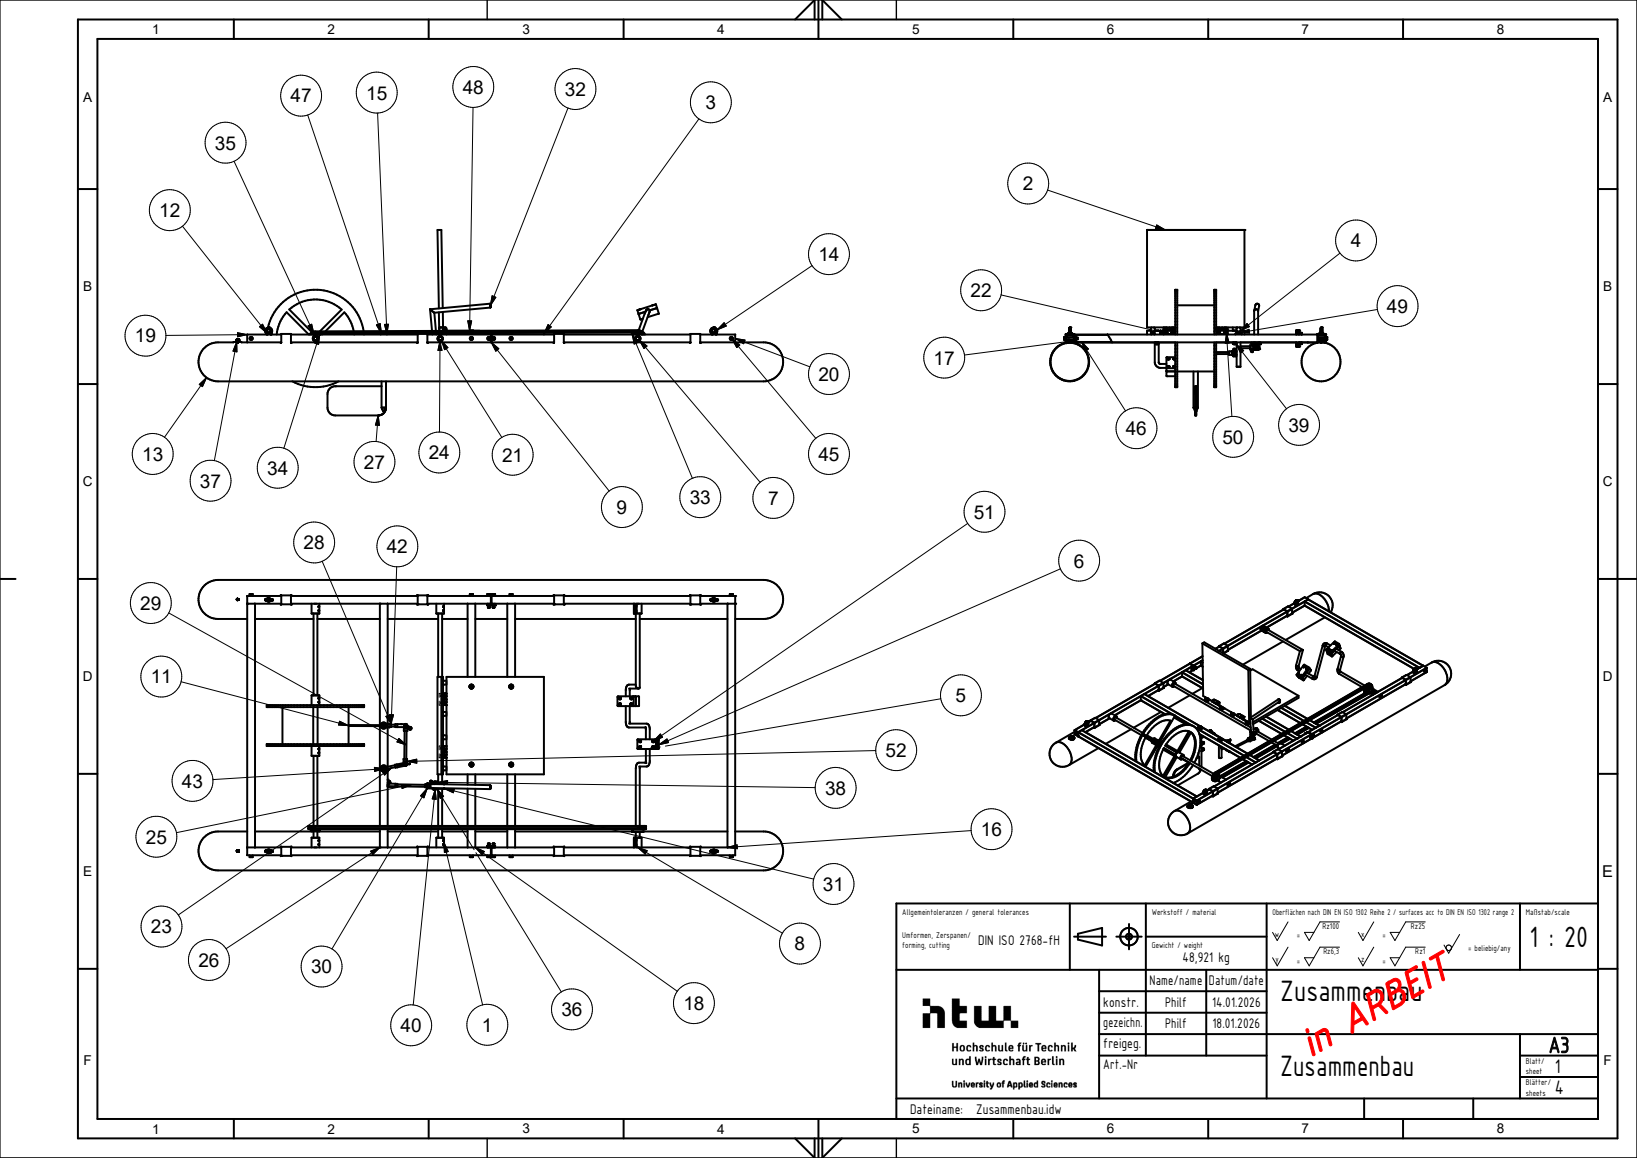
[picture p28: page 1]
Philf; Zusammenbau; 1 Blatt/ sheet Blätter/; sheets; = beliebig/any w; Maßstab/scale Umformen, Zerspanen/; forming, cutting; DIN ISO 2768-fH; in ARBEIT

Allgemeintoleranzen / general tolerances

Zusammenbau Werkstoff / material Gewicht / weight

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

Name/name Datum/date
konstr.
gezeichn.
freigeg.
Art.-Nr

Dateiname: Zusammenbau.idw
